peteryates1/atari800-spinalhdl/boards/rp2040-qmtech-10cl025/20260721_135031.jpg

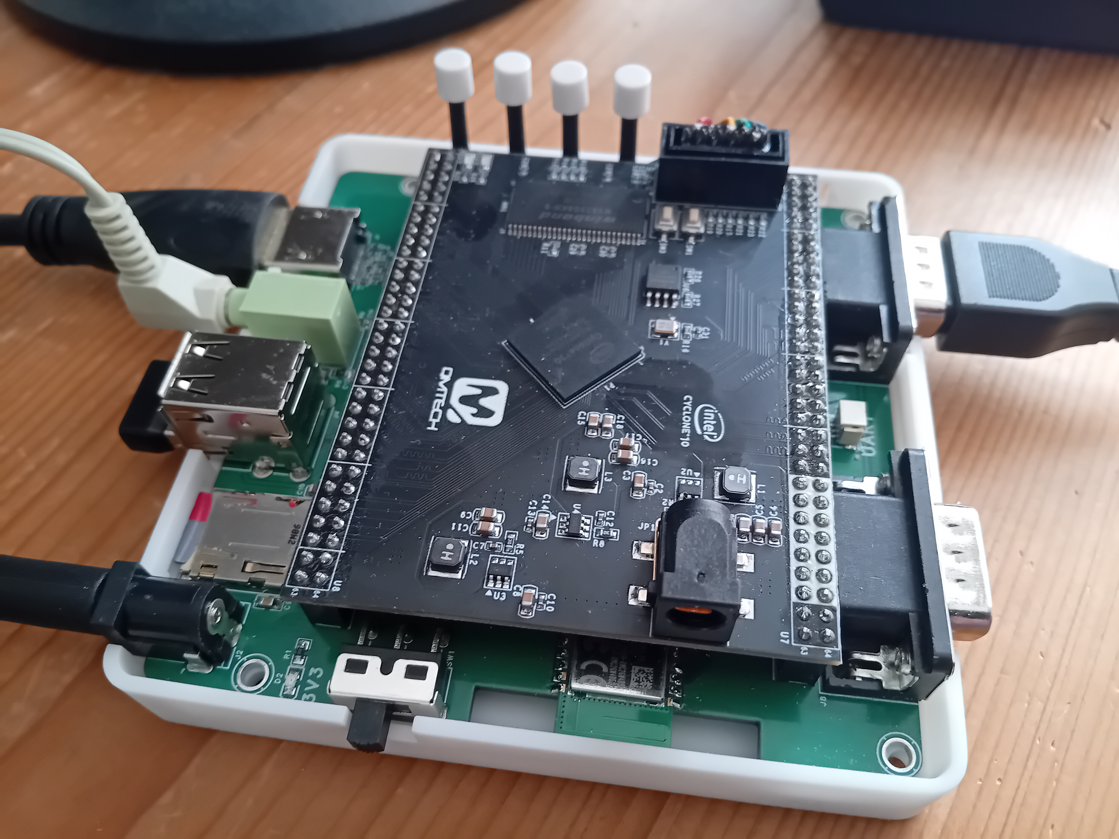
boards/rp2040-qmtech-10cl025/20260721_135031.jpg
