peteryates1/atari800-spinalhdl/boards/rp2040-qmtech-10cl025/20260721_135143.jpg

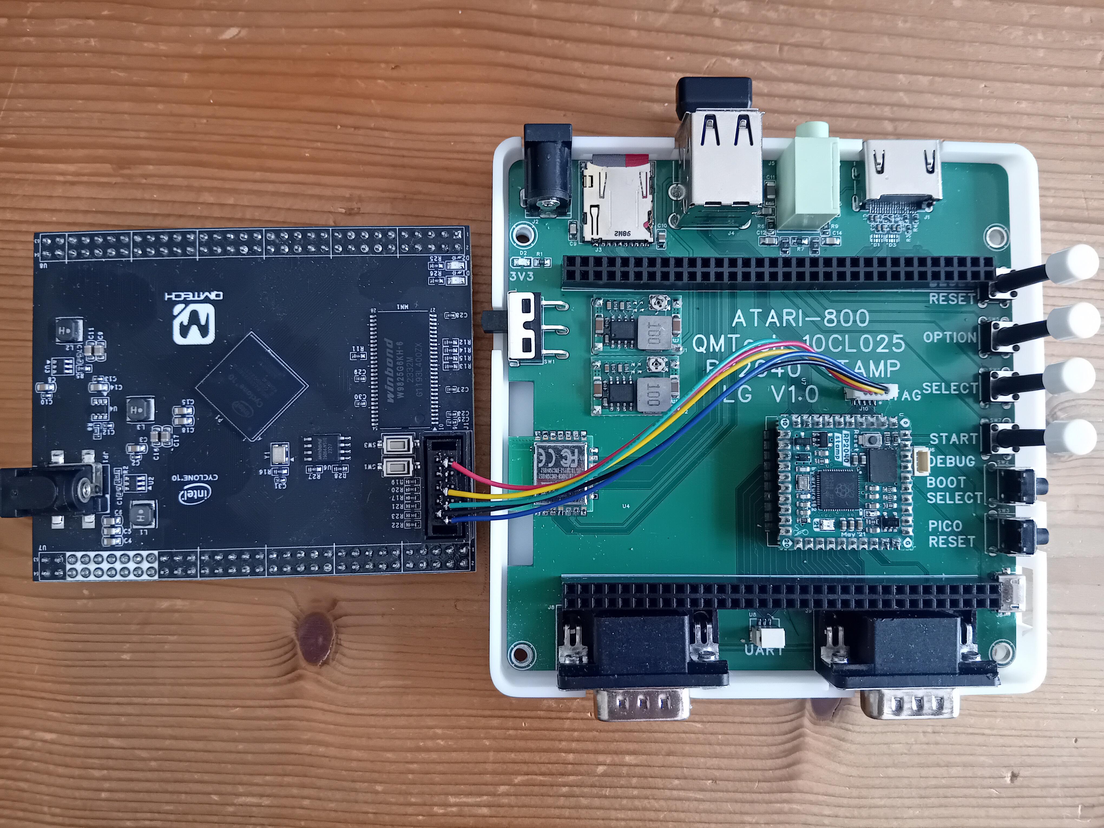
boards/rp2040-qmtech-10cl025/20260721_135143.jpg
