peteryates1/atari800-spinalhdl/boards/fpga-db-colorlight-i5/BOM_fpga-db-colorlight-i5_fpga-db-colorlight-i5_2026-08-14.csv

No. | Quantity | Comment | Value | Manufacturer Part | Designator | Footprint
1 | 16 | 100nF | 100nF | CC0402KRX7R7BB104 | C1,C2,C3,C4,C5,C6,C7,C8,C9,C10,C17,C19,C25,C26,C28,C30 | C0402
2 | 2 | 100uF | 100uF | CL31A107MQHNNNE | C11,C16 | C1206
3 | 4 | 10nF | 10nF | CL21B103KBANNNC | C12,C13,C14,C15 | C0805
4 | 7 | 10uF | 10uF | CL21A106KAYNNNE | C18,C24,C27,C29,C31,C32,C33 | C0805
5 | 4 | 22nF | 22nF | CC0402KRX7R7BB104 | C20,C21,C22,C23 | C0402
6 | 2 | AZ1045-04F |  | AZ1045-04F | D1,D2 | DFN2510-10_L2.5-W1.0-P0.50-BL
7 | 9 | LED_0805-R |  |  | D3,D4,D5,D6,D7,D8,D9,D10,D11 | LED0805-R-RD
8 | 1 | HDR-M_2.54_1x2P |  |  | H1 | HDR-TH_2P-P2.54-V-M-1
9 | 1 | HDMI-01 |  | HDMI-01 | HDMI1 | USB-SMD_HDMI-01
10 | 1 | DC-005-2.5-EP |  | DC-005-2.5-EP | J1 | DC-IN-TH_DC-005-2.5-EP
11 | 1 | BM05B-SRSS-TB(LF)(SN) |  | BM05B-SRSS-TB(LF)(SN) | J2 | CONN-SMD-5P-P1.00_BM05B-SRSS-TB-LF-SN
12 | 1 | USB2.0-AF-SS-17.6 |  | USB2.0-AF-SS-17.6 | J3 | USB-A-TH_USB2.0-AF-SS-17.6
13 | 1 | U-F-M5SS-W-1 |  | U-F-M5SS-W-1 | J4 | MICRO-USB-SMD_U-F-M5SS-W-1
14 | 1 | PJ-325C5-G |  | PJ-325C5-G | J5 | AUDIO-TH_PJ-325C5-G
15 | 2 | XDDB-1809-0816 |  | XDDB-1809-0816 | J6,J7 | DB9-TH_LD09P33E4GV00LF
16 | 1 | {ManufacturerPart!} |  | DM3AT-SF-PEJM5 | J8 | SD-SMD_DM3AT-SF-PEJM5
17 | 11 | 300Ω | 300Ω |  | R1,R10,R11,R12,R13,R14,R15,R16,R17,R18,R19 | R0402
18 | 6 | 10kΩ | 10kΩ | FRC0402F1002TS | R2,R3,R4,R21,R22,R23 | R0402
19 | 4 | 560Ω | 560Ω | 0805W8F5600T5E | R5,R6,R8,R9 | R0805
20 | 1 | 0Ω | 0Ω |  | R20 | R0402
21 | 1 | HR911130A |  | HR911130A | RJ1 | RJ45-TH_HR911130A
22 | 1 | SS12D11G5 |  | SS12D11G5 | SW1 | SW-TH_SS12D11G5
23 | 6 | TS-1088-AR02016 |  | TS-1088-AR02016 | SW2,SW3,SW4,SW5,SW6,SW7 | SW-SMD_L3.9-W3.0-P4.45
24 | 1 | DSN-MINI-360 |  |  | U1 | DSN-MINI-360
25 | 1 | RP2040_Stamp_RP2040_Stamp | RP2040_Stamp |  | U2 | RP2040_Stamp_THT
26 | 1 | IS63LV1024L-10TLI |  | IS63LV1024L-10TLI | U3 | TSOP-32_L21.0-W10.2-P1.27-LS11.8-BL
27 | 1 | SM03B-SRSS-TB(LF)(SN) |  | SM03B-SRSS-TB(LF)(SN) | U4 | CONN-SMD_SM03B-SRSS-TB-LF-SN-P
28 | 1 | colorlight-i9+ horz |  |  | U5 | CONN-SMD_200P-P0.60_AS0A426-K2SN-4H
