peteryates1/atari800-spinalhdl/boards/atari800-lg-v1.1/hw/3DShell_ATARI-800-QMTechCB-LG-V1_1/3DShell_3DShell_ATARI-800-QMTechCB-LG-V1_1_B.step

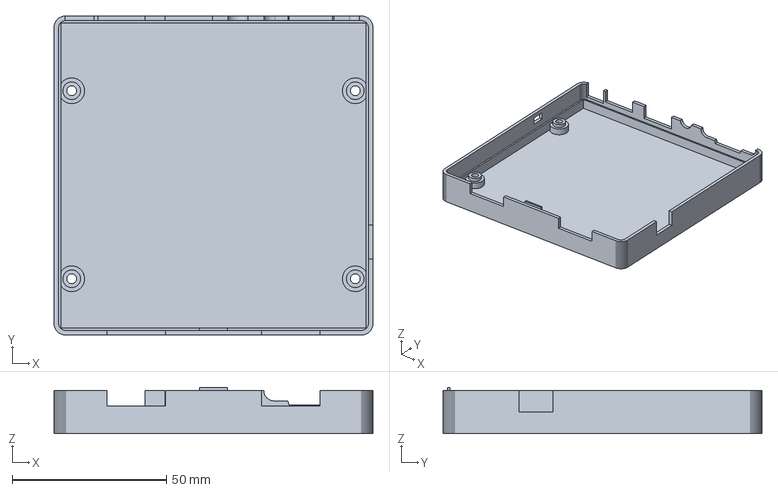
[picture p6: CAD file, 2026-05-06, last stored version]
boards/atari800-lg-v1.1/hw/3DShell_ATARI-800-QMTechCB-LG-V1_1/3DShell_3DShell_ATARI-800-QMTechCB-LG-V1_1_B.step
103.5 x 103.5 x 15.0 mm
