peteryates1/atari800-spinalhdl/boards/rp2040-qmtech-xc7a100t/SCH_ATARI-800-QMTech-XC7A100T-CB-RP2040-STAMP-HDMI_1_2026-07-22.pdf

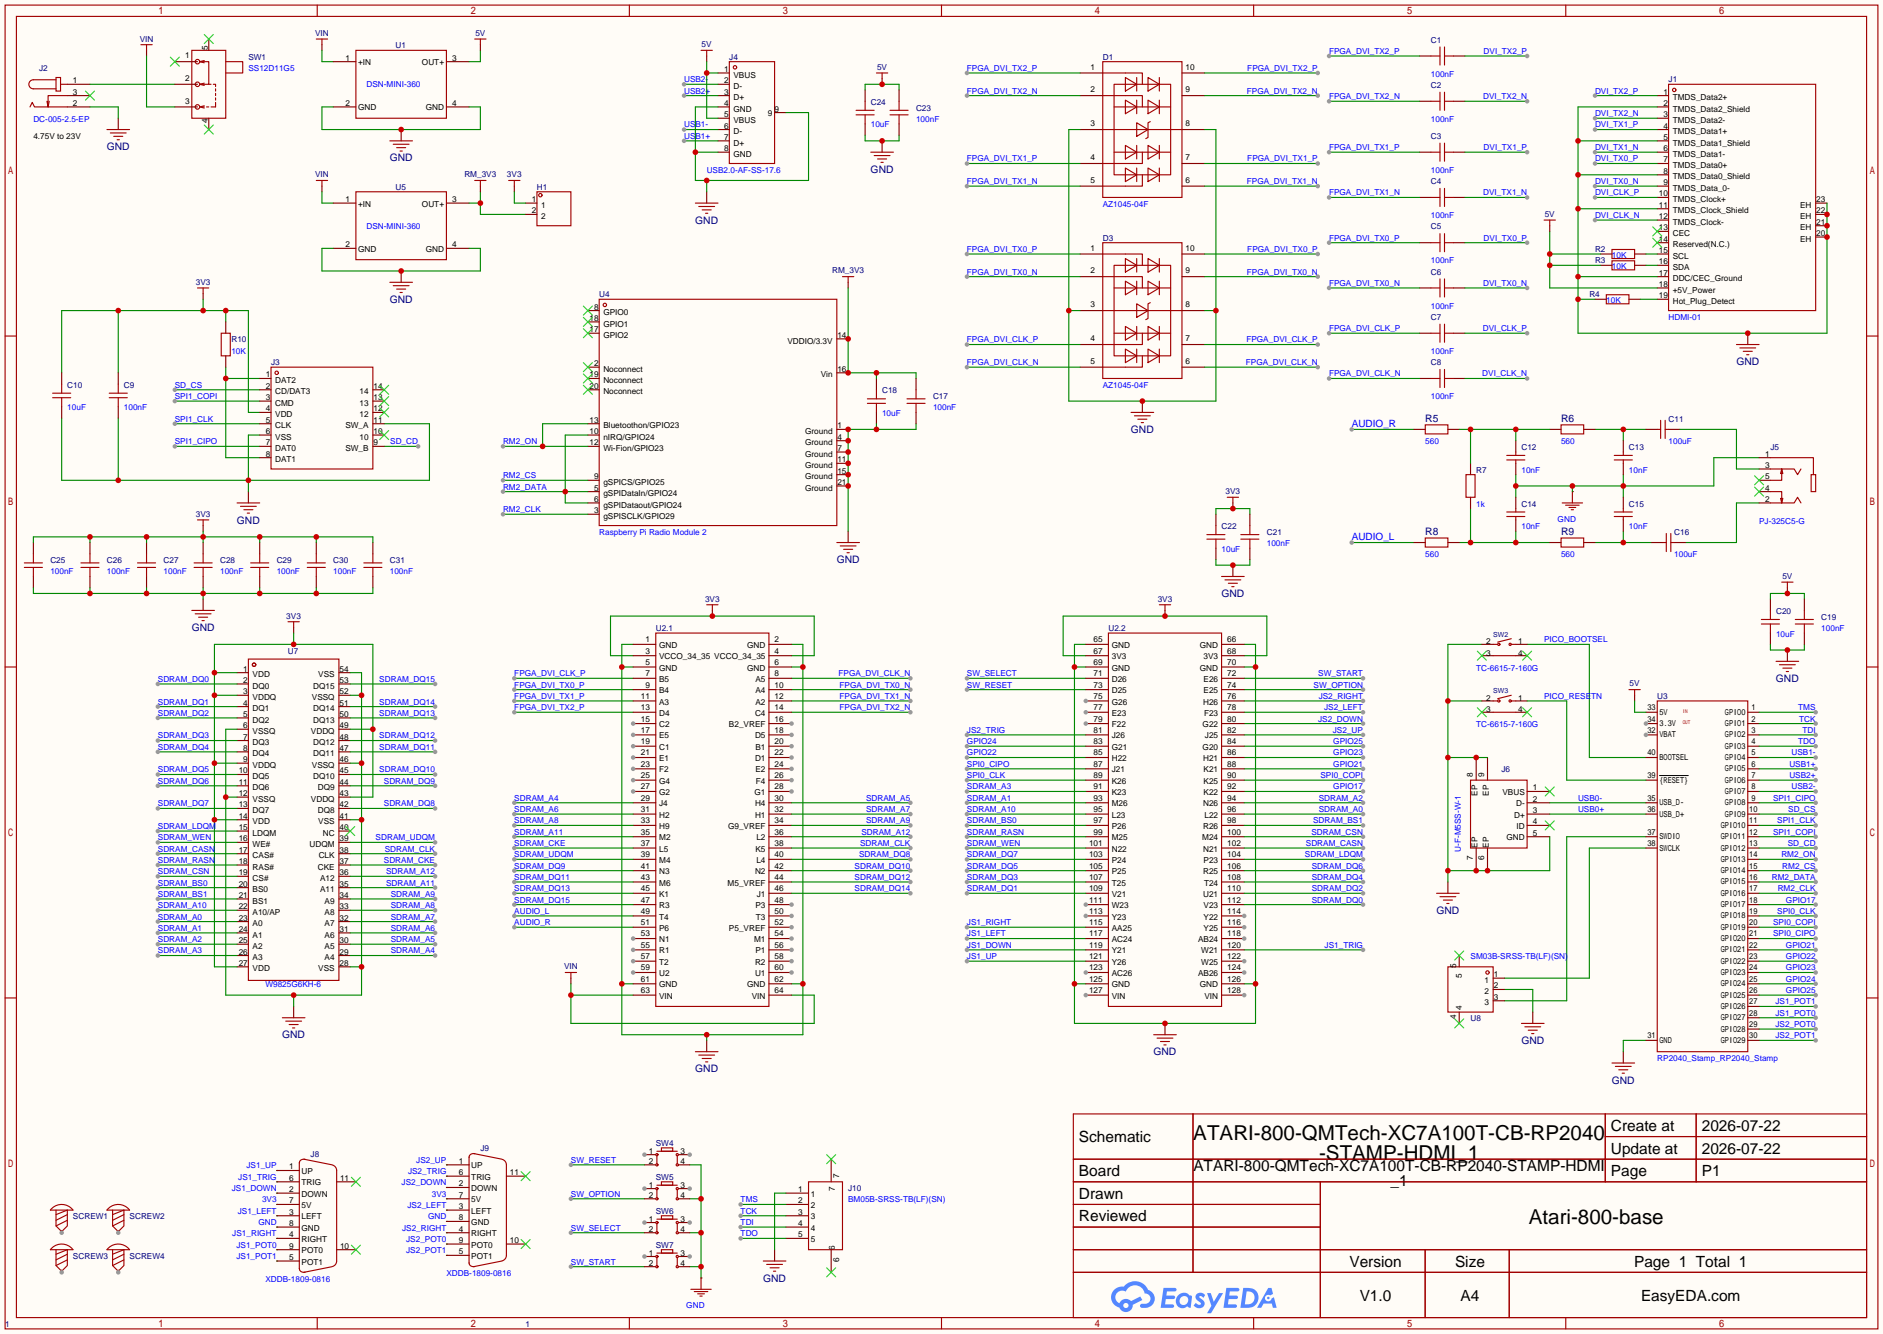
[picture p7: page 1]

Ground 1
Ground 4
Ground 21 Ground 15 Ground 11 Ground 7

Raspberry Pi Radio Module 2

GND
VIN 128 GND 126 AB26 124 W25 122 W21 120 AB24 118 Y25 116 Y22 114 V23 112 U21 110 T24 108 R25 106 P23 104 N21 102 M24 100 R26 98 L22 96 N26 94 K22 92 K25 90 K21 88 H21 86 G20 84 J25 82 G22 80 F23 78 H26 76 E25 74 E26 72 GND 70 3V3 68 GND 66

VIN 127 GND 125 AC26 123 Y26 121 Y21 119 AC24 117 AA25 115 Y23 113 W23 111 V21 109 T25 107 P25 105 P24 103 N22 101 M25 99 P26 97 L23 95 M26 93 K23 91 K26 89 J21 87 H22 85 G21 83 J26 81 F22 79 E23 77 G26 75 D25 73 D26 71 GND 69 3V3 67 GND 65

Schematic | ATARI-800-QMTech-XC7A100T-CB-RP2040 -STAMP-HDMI_1 | Create at | 2026-07-22

Update at | 2026-07-22

Board | ATARI-800-QMTech-XC7A100T-CB-RP2040-STAMP-HDMI | Page | P1

Version | Size | Page 1 Total 1
V1.0 | A4 | EasyEDA.com
