peteryates1/atari800-spinalhdl/boards/rp2040-colorlight/fpga/i9plus.xdc

# Colorlight i9+ (XC7A50T-FGG484) base-board pin map — generated from netlist
set_property -dict { PACKAGE_PIN R2 IOSTANDARD LVCMOS33 } [get_ports { GPIO17 }]
set_property -dict { PACKAGE_PIN P5 IOSTANDARD LVCMOS33 } [get_ports { JS2_RIGHT }]
set_property -dict { PACKAGE_PIN T6 IOSTANDARD LVCMOS33 } [get_ports { JS2_LEFT }]
set_property -dict { PACKAGE_PIN U7 IOSTANDARD LVCMOS33 } [get_ports { JS2_DOWN }]
set_property -dict { PACKAGE_PIN U6 IOSTANDARD LVCMOS33 } [get_ports { JS2_TRIG }]
set_property -dict { PACKAGE_PIN T3 IOSTANDARD LVCMOS33 } [get_ports { GPIO16 }]
set_property -dict { PACKAGE_PIN U5 IOSTANDARD LVCMOS33 } [get_ports { JS2_UP }]
set_property -dict { PACKAGE_PIN T4 IOSTANDARD LVCMOS33 } [get_ports { GPIO15 }]
set_property -dict { PACKAGE_PIN V5 IOSTANDARD LVCMOS33 } [get_ports { JS1_RIGHT }]
set_property -dict { PACKAGE_PIN U1 IOSTANDARD LVCMOS33 } [get_ports { JS1_LEFT }]
set_property -dict { PACKAGE_PIN U2 IOSTANDARD LVCMOS33 } [get_ports { GPIO14 }]
set_property -dict { PACKAGE_PIN H3 IOSTANDARD LVCMOS33 } [get_ports { JS1_DOWN }]
set_property -dict { PACKAGE_PIN U3 IOSTANDARD LVCMOS33 } [get_ports { GPIO13 }]
set_property -dict { PACKAGE_PIN J1 IOSTANDARD LVCMOS33 } [get_ports { JS1_TRIG }]
set_property -dict { PACKAGE_PIN V2 IOSTANDARD LVCMOS33 } [get_ports { GPIO12 }]
set_property -dict { PACKAGE_PIN K1 IOSTANDARD LVCMOS33 } [get_ports { JS1_UP }]
set_property -dict { PACKAGE_PIN V3 IOSTANDARD LVCMOS33 } [get_ports { GPIO11 }]
set_property -dict { PACKAGE_PIN L1 IOSTANDARD LVCMOS33 } [get_ports { SW_RESET }]
set_property -dict { PACKAGE_PIN W1 IOSTANDARD LVCMOS33 } [get_ports { GPIO10 }]
set_property -dict { PACKAGE_PIN M1 IOSTANDARD LVCMOS33 } [get_ports { SW_OPTION }]
set_property -dict { PACKAGE_PIN Y1 IOSTANDARD LVCMOS33 } [get_ports { GPIO9 }]
set_property -dict { PACKAGE_PIN J2 IOSTANDARD LVCMOS33 } [get_ports { SW_SELECT }]
set_property -dict { PACKAGE_PIN AA1 IOSTANDARD LVCMOS33 } [get_ports { FPGA_DVI_CLK_N }]
set_property -dict { PACKAGE_PIN K2 IOSTANDARD LVCMOS33 } [get_ports { SW_START }]
set_property -dict { PACKAGE_PIN AB1 IOSTANDARD LVCMOS33 } [get_ports { FPGA_DVI_CLK_P }]
set_property -dict { PACKAGE_PIN W2 IOSTANDARD LVCMOS33 } [get_ports { GPIO18 }]
set_property -dict { PACKAGE_PIN Y2 IOSTANDARD LVCMOS33 } [get_ports { GPIO19 }]
set_property -dict { PACKAGE_PIN AB2 IOSTANDARD LVCMOS33 } [get_ports { GPIO21 }]
set_property -dict { PACKAGE_PIN AA3 IOSTANDARD LVCMOS33 } [get_ports { FPGA_DVI_TX0_N }]
set_property -dict { PACKAGE_PIN AB3 IOSTANDARD LVCMOS33 } [get_ports { GPIO20 }]
set_property -dict { PACKAGE_PIN Y3 IOSTANDARD LVCMOS33 } [get_ports { FPGA_DVI_TX0_P }]
set_property -dict { PACKAGE_PIN R3 IOSTANDARD LVCMOS33 } [get_ports { LED3 }]
set_property -dict { PACKAGE_PIN M3 IOSTANDARD LVCMOS33 } [get_ports { LED2 }]
set_property -dict { PACKAGE_PIN V4 IOSTANDARD LVCMOS33 } [get_ports { LED1 }]
set_property -dict { PACKAGE_PIN R4 IOSTANDARD LVCMOS33 } [get_ports { LED0 }]
set_property -dict { PACKAGE_PIN T5 IOSTANDARD LVCMOS33 } [get_ports { SRAM_A0 }]
set_property -dict { PACKAGE_PIN J5 IOSTANDARD LVCMOS33 } [get_ports { SRAM_A16 }]
set_property -dict { PACKAGE_PIN Y6 IOSTANDARD LVCMOS33 } [get_ports { FPGA_DVI_TX1_N }]
set_property -dict { PACKAGE_PIN J6 IOSTANDARD LVCMOS33 } [get_ports { SRAM_A1 }]
set_property -dict { PACKAGE_PIN W5 IOSTANDARD LVCMOS33 } [get_ports { SRAM_A15 }]
set_property -dict { PACKAGE_PIN AA6 IOSTANDARD LVCMOS33 } [get_ports { FPGA_DVI_TX1_P }]
set_property -dict { PACKAGE_PIN L5 IOSTANDARD LVCMOS33 } [get_ports { SRAM_A2 }]
set_property -dict { PACKAGE_PIN L6 IOSTANDARD LVCMOS33 } [get_ports { SRAM_A14 }]
set_property -dict { PACKAGE_PIN W6 IOSTANDARD LVCMOS33 } [get_ports { SRAM_A3 }]
set_property -dict { PACKAGE_PIN AA8 IOSTANDARD LVCMOS33 } [get_ports { FPGA_DVI_TX2_N }]
set_property -dict { PACKAGE_PIN V7 IOSTANDARD LVCMOS33 } [get_ports { SRAM_A13 }]
set_property -dict { PACKAGE_PIN AB8 IOSTANDARD LVCMOS33 } [get_ports { FPGA_DVI_TX2_P }]
set_property -dict { PACKAGE_PIN N13 IOSTANDARD LVCMOS33 } [get_ports { SRAM_CE_N }]
set_property -dict { PACKAGE_PIN N14 IOSTANDARD LVCMOS33 } [get_ports { SRAM_OE_N }]
set_property -dict { PACKAGE_PIN P15 IOSTANDARD LVCMOS33 } [get_ports { SRAM_D0 }]
set_property -dict { PACKAGE_PIN P16 IOSTANDARD LVCMOS33 } [get_ports { SRAM_D7 }]
set_property -dict { PACKAGE_PIN R16 IOSTANDARD LVCMOS33 } [get_ports { SRAM_D1 }]
set_property -dict { PACKAGE_PIN N17 IOSTANDARD LVCMOS33 } [get_ports { SRAM_D6 }]
set_property -dict { PACKAGE_PIN T18 IOSTANDARD LVCMOS33 } [get_ports { SRAM_D5 }]
set_property -dict { PACKAGE_PIN R17 IOSTANDARD LVCMOS33 } [get_ports { SRAM_D2 }]
set_property -dict { PACKAGE_PIN U18 IOSTANDARD LVCMOS33 } [get_ports { SRAM_D4 }]
set_property -dict { PACKAGE_PIN R18 IOSTANDARD LVCMOS33 } [get_ports { SRAM_D3 }]
set_property -dict { PACKAGE_PIN N18 IOSTANDARD LVCMOS33 } [get_ports { SRAM_A12 }]
set_property -dict { PACKAGE_PIN R19 IOSTANDARD LVCMOS33 } [get_ports { SRAM_WE_N }]
set_property -dict { PACKAGE_PIN N19 IOSTANDARD LVCMOS33 } [get_ports { SRAM_A11 }]
set_property -dict { PACKAGE_PIN N15 IOSTANDARD LVCMOS33 } [get_ports { SRAM_A4 }]
set_property -dict { PACKAGE_PIN M16 IOSTANDARD LVCMOS33 } [get_ports { SRAM_A10 }]
set_property -dict { PACKAGE_PIN M15 IOSTANDARD LVCMOS33 } [get_ports { SRAM_A5 }]
set_property -dict { PACKAGE_PIN L15 IOSTANDARD LVCMOS33 } [get_ports { SRAM_A9 }]
set_property -dict { PACKAGE_PIN L16 IOSTANDARD LVCMOS33 } [get_ports { SRAM_A6 }]
set_property -dict { PACKAGE_PIN AB21 IOSTANDARD LVCMOS33 } [get_ports { AUDIO_R }]
set_property -dict { PACKAGE_PIN K14 IOSTANDARD LVCMOS33 } [get_ports { SRAM_A8 }]
set_property -dict { PACKAGE_PIN Y21 IOSTANDARD LVCMOS33 } [get_ports { AUDIO_L }]
set_property -dict { PACKAGE_PIN N22 IOSTANDARD LVCMOS33 } [get_ports { SRAM_A7 }]
