peteryates1/atari800-spinalhdl/firmware/supervisor/tusb_config.h

/*
 * The MIT License (MIT)
 *
 * Copyright (c) 2019 Ha Thach (tinyusb.org)
 *
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
 */

#ifndef TUSB_CONFIG_H_
#define TUSB_CONFIG_H_

#ifdef __cplusplus
 extern "C" {
#endif

//--------------------------------------------------------------------+
// Board Specific Configuration
//--------------------------------------------------------------------+

// RHPort number used for device can be defined by board.mk, default to port 0
#ifndef BOARD_TUD_RHPORT
#define BOARD_TUD_RHPORT      0
#endif

// RHPort max operational speed can defined by board.mk
#ifndef BOARD_TUD_MAX_SPEED
#define BOARD_TUD_MAX_SPEED   OPT_MODE_DEFAULT_SPEED
#endif

// RHPort number used for host can be defined by board.mk, default to port 1
#ifndef BOARD_TUH_RHPORT
#define BOARD_TUH_RHPORT      1
#endif

// RHPort max operational speed can defined by board.mk
#ifndef BOARD_TUH_MAX_SPEED
#define BOARD_TUH_MAX_SPEED   OPT_MODE_DEFAULT_SPEED
#endif

//--------------------------------------------------------------------
// COMMON CONFIGURATION
//--------------------------------------------------------------------

// defined by compiler flags for flexibility
#ifndef CFG_TUSB_MCU
#error CFG_TUSB_MCU must be defined
#endif

#ifndef CFG_TUSB_OS
#define CFG_TUSB_OS           OPT_OS_NONE
#endif

#ifndef CFG_TUSB_DEBUG
#define CFG_TUSB_DEBUG        0
#endif

// Enable Device stack, Default is max speed that hardware controller could support with on-chip PHY
#define CFG_TUD_ENABLED       1
#define CFG_TUD_MAX_SPEED     BOARD_TUD_MAX_SPEED

// Enable Host stack, Default is max speed that hardware controller could support with on-chip PHY
#define CFG_TUH_ENABLED       1
#define CFG_TUH_MAX_SPEED     BOARD_TUH_MAX_SPEED

#if CFG_TUSB_MCU == OPT_MCU_RP2040
// Use pico-pio-usb as host controller for raspberry rp2040
#define CFG_TUH_RPI_PIO_USB   1
#endif

/* USB DMA on some MCUs can only access a specific SRAM region with restriction on alignment.
 * Tinyusb use follows macros to declare transferring memory so that they can be put
 * into those specific section.
 * e.g
 * - CFG_TUSB_MEM SECTION : __attribute__ (( section(".usb_ram") ))
 * - CFG_TUSB_MEM_ALIGN   : __attribute__ ((aligned(4)))
 */
#ifndef CFG_TUD_MEM_SECTION
#define CFG_TUD_MEM_SECTION
#endif

#ifndef CFG_TUD_MEM_ALIGN
#define CFG_TUD_MEM_ALIGN        __attribute__ ((aligned(4)))
#endif

//--------------------------------------------------------------------
// DEVICE CONFIGURATION
//--------------------------------------------------------------------

#ifndef CFG_TUD_ENDPOINT0_SIZE
#define CFG_TUD_ENDPOINT0_SIZE    64
#endif

//------------- CLASS -------------//
#define CFG_TUD_CDC              1

// CDC FIFO size of TX and RX
#define CFG_TUD_CDC_RX_BUFSIZE   (TUD_OPT_HIGH_SPEED ? 512 : 64)
#define CFG_TUD_CDC_TX_BUFSIZE   (TUD_OPT_HIGH_SPEED ? 512 : 64)

// CDC Endpoint transfer buffer size, more is faster
#define CFG_TUD_CDC_EP_BUFSIZE   (TUD_OPT_HIGH_SPEED ? 512 : 64)

// Vendor class: used only for the USB-Blaster (FTDI 09fb:6001) identity that
// the device re-enumerates into for FPGA JTAG programming (see blaster.c /
// g_blaster_mode). Buffers per the pico-usb-blaster reference: a large RX FIFO
// keeps NAKs down when jtagd streams; TX is one FT245 packet.
#define CFG_TUD_VENDOR            1
#define CFG_TUD_VENDOR_EPSIZE     64
#define CFG_TUD_VENDOR_RX_BUFSIZE 1024
#define CFG_TUD_VENDOR_TX_BUFSIZE 64

// Mass Storage: exposes the SD card as a USB drive so files/configs can be
// dropped and edited without pulling the card (see msc_disk.c). One 512-byte
// block per bulk transfer.
#define CFG_TUD_MSC               1
#define CFG_TUD_MSC_EP_BUFSIZE    512

//--------------------------------------------------------------------
// HOST CONFIGURATION
//--------------------------------------------------------------------

// Size of buffer to hold descriptors and other data used for enumeration
#define CFG_TUH_ENUMERATION_BUFSIZE 256

#ifndef CFG_TUH_MEM_SECTION
#define CFG_TUH_MEM_SECTION
#endif

#ifndef CFG_TUH_MEM_ALIGN
#define CFG_TUH_MEM_ALIGN           __attribute__ ((aligned(4)))
#endif

#define CFG_TUH_HUB                 1
// max device support (excluding hub device)
#define CFG_TUH_DEVICE_MAX          (CFG_TUH_HUB ? 4 : 1) // hub typically has 4 ports

#define CFG_TUH_HID                 (3*CFG_TUH_DEVICE_MAX)
// Ask boot-capable keyboards for the simple 8-byte boot protocol at mount
#define CFG_TUH_HID_DEFAULT_PROTOCOL HID_PROTOCOL_BOOT
#define CFG_TUH_HID_EPIN_BUFSIZE    64
#define CFG_TUH_HID_EPOUT_BUFSIZE   64

#ifdef __cplusplus
 }
#endif

#endif
