peteryates1/atari800-spinalhdl/boards/i5-7v0/oddrx2f_720/pll_hdmi_ecp5.sv

// diamond 3.7 accepts this PLL
// diamond 3.8-3.9 is untested
// diamond 3.10 or higher is likely to abort with error about unable to use feedback signal
// cause of this could be from wrong CPHASE/FPHASE parameters
module pll_hdmi_ecp5
(
    input clkin, // 25 MHz, 0 deg
    output clkout0, // 370 MHz, 0 deg (serial)
    output clkout1, // 74 MHz, 0 deg (pixel)
    output clkout2, // 37 MHz, 0 deg (Atari sys) - VCO=740/20, phase-locked to pixel (1:2)
    output locked
);
(* FREQUENCY_PIN_CLKI="25" *)
(* FREQUENCY_PIN_CLKOP="370" *)
(* FREQUENCY_PIN_CLKOS="74" *)
(* FREQUENCY_PIN_CLKOS2="37" *)
(* ICP_CURRENT="12" *) (* LPF_RESISTOR="8" *) (* MFG_ENABLE_FILTEROPAMP="1" *) (* MFG_GMCREF_SEL="2" *)
EHXPLLL #(
        .PLLRST_ENA("DISABLED"),
        .INTFB_WAKE("DISABLED"),
        .STDBY_ENABLE("DISABLED"),
        .DPHASE_SOURCE("DISABLED"),
        .OUTDIVIDER_MUXA("DIVA"),
        .OUTDIVIDER_MUXB("DIVB"),
        .OUTDIVIDER_MUXC("DIVC"),
        .OUTDIVIDER_MUXD("DIVD"),
        .CLKI_DIV(5),
        .CLKOP_ENABLE("ENABLED"),
        .CLKOP_DIV(2),
        .CLKOP_CPHASE(1),
        .CLKOP_FPHASE(0),
        .CLKOS_ENABLE("ENABLED"),
        .CLKOS_DIV(10),
        .CLKOS_CPHASE(1),
        .CLKOS_FPHASE(0),
        .CLKOS2_ENABLE("ENABLED"),
        .CLKOS2_DIV(20),
        .CLKOS2_CPHASE(1),
        .CLKOS2_FPHASE(0),
        .FEEDBK_PATH("CLKOP"),
        .CLKFB_DIV(74)
    ) pll_i (
        .RST(1'b0),
        .STDBY(1'b0),
        .CLKI(clkin),
        .CLKOP(clkout0),
        .CLKOS(clkout1),
        .CLKOS2(clkout2),
        .CLKFB(clkout0),
        .CLKINTFB(),
        .PHASESEL0(1'b0),
        .PHASESEL1(1'b0),
        .PHASEDIR(1'b1),
        .PHASESTEP(1'b1),
        .PHASELOADREG(1'b1),
        .PLLWAKESYNC(1'b0),
        .ENCLKOP(1'b0),
        .LOCK(locked)
	);
endmodule
