peteryates1/atari800-spinalhdl/firmware/supervisor/ft245_eeprom.h

// Reproduction of the EEPROM from the original Altera "USB Blaster".
// Derived from the code at http://sa89a.net/mp.cgi/ele/ub.htm
// Returned to the host via the FTDI READ_EEPROM (0x90) vendor control request
// so Quartus / jtagd accept the device as a genuine USB-Blaster.
#pragma once

#include <stdint.h>

#define FT245_EEPROM_LENGTH (sizeof(FT245_EEPROM)/sizeof(FT245_EEPROM[0]))

static uint8_t FT245_EEPROM[] = {
    0x00, 0x00, 0xFB, 0x09, 0x01, 0x60, 0x00, 0x04, 	// 0x00 - 0x07
    0x80, 0x28, 0x1C, 0x00, 0x10, 0x01, 0x94, 0x0E, 	// 0x08 - 0x0F
    0xA2, 0x18, 0xBA, 0x12, 0x0E, 0x03, 0x41, 0x00, 	// 0x10 - 0x17
    0x6C, 0x00, 0x74, 0x00, 0x65, 0x00, 0x72, 0x00, 	// 0x18 - 0x1F
    0x61, 0x00, 0x18, 0x03, 0x55, 0x00, 0x53, 0x00, 	// 0x20 - 0x27
    0x42, 0x00, 0x2D, 0x00, 0x42, 0x00, 0x6C, 0x00, 	// 0x28 - 0x2F
    0x61, 0x00, 0x73, 0x00, 0x74, 0x00, 0x65, 0x00, 	// 0x30 - 0x37
    0x72, 0x00, 0x12, 0x03, 0x30, 0x00, 0x30, 0x00, 	// 0x38 - 0x3F
    0x30, 0x00, 0x30, 0x00, 0x30, 0x00, 0x30, 0x00, 	// 0x40 - 0x47
    0x30, 0x00, 0x30, 0x00, 0x01, 0x02, 0x03, 0x01, 	// 0x48 - 0x4F
    0x00, 0x00, 0x00, 0x00, 0x00, 0x00, 0x00, 0x00, 	// 0x50 - 0x57
    0x00, 0x00, 0x00, 0x00, 0x00, 0x00, 0x00, 0x00, 	// 0x58 - 0x5F
    0x00, 0x00, 0x00, 0x00, 0x00, 0x00, 0x00, 0x00, 	// 0x60 - 0x67
    0x00, 0x00, 0x00, 0x00, 0x00, 0x00, 0x00, 0x00, 	// 0x68 - 0x6F
    0x00, 0x00, 0x00, 0x00, 0x00, 0x00, 0x00, 0x00, 	// 0x70 - 0x77
    0x00, 0x00, 0x00, 0x00, 0x00, 0x00, 0x85, 0xD0, 	// 0x78 - 0x7F
};
