peteryates1/atari800-spinalhdl/boards/rp2040-qmtech-10cl025/hdmi_ref_480/rtl/hdmi_color.v

/***************************************************
*	Module Name		:	hdmi_color		   
*	Engineer			:	小梅哥
*	Target Device	:	10CL025YU256C8
*	Tool versions	:	Quartus Prime 18.1
*	Create Date		:	2021-12-20
*	Revision			:	v1.0
*	Description		:  HDMI彩条实验顶层模块设计
**************************************************/

module hdmi_color(
	input clk,
	input rst_n,
	
	//hdmi output
	output tmds_clk_p,
	output tmds_clk_n,
	output [2:0] tmds_data_p, //rgb
	output [2:0] tmds_data_n //rgb
);

	wire clk_vga;//25m (640x480 test — was 74.25m)
	wire clk_vgax5;//125m (5x — was 371.25m)

	// Reuse the proven atari_pll (25 MHz c1 / 125 MHz c2) instead of pll_hdmi.
	atari_pll pll_hdmi_inst(
		.areset(1'b0),
		.inclk0(clk),
		.c0(),
		.c1(clk_vga),
		.c2(clk_vgax5),
		.c3(),
		.locked()
	);

	wire [11:0] hcount;
	wire [11:0] vcount;
	wire [23:0] disp_data;
	color_bar u_color_bar(
		.hcount(hcount),
		.vcount(vcount),
		.disp_data(disp_data)
	);
 
	wire video_hs;
	wire video_vs;
	wire video_de;
	wire [7:0] video_r;
	wire [7:0] video_g;
	wire [7:0] video_b;
 
	disp_driver disp_driver(
		.ClkDisp(clk_vga),
		.Rst_n(rst_n),
		.Data(disp_data),
		.DataReq(),
		.H_Addr(hcount),
		.V_Addr(vcount),
		.Disp_HS(video_hs),
		.Disp_VS(video_vs),
		.Disp_Red(video_r),
		.Disp_Green(video_g),
		.Disp_Blue(video_b),
		.Disp_DE(video_de),
		.Disp_PCLK()
	);
	
	dvi_encoder u_dvi_encoder(
		.pixelclk(clk_vga),// system clock
		.pixelclk5x(clk_vgax5),// system clock x5
		.rst_n(rst_n),// reset
		.blue_din(video_b),// Blue data in
		.green_din(video_g),// Green data in
		.red_din(video_r),// Red data in
		.hsync(video_hs),// hsync data
		.vsync(video_vs),// vsync data
		.de(video_de),// data enable
		.tmds_clk_p(tmds_clk_p),
		.tmds_clk_n(tmds_clk_n),
		.tmds_data_p(tmds_data_p),//rgb
		.tmds_data_n(tmds_data_n) //rgb
	);
 
endmodule
