peteryates1/atari800-spinalhdl/(commit log)

2026-03-12 Update for pluggable I/O: rename BmbAtariCtrl→AtariCtrl, unified build
    - Rename BmbAtariCtrl → AtariCtrl (no BMB signals)
    - Move JopCoreForAtari from jop-bridge to atari/
    - Delete jop-bridge/GenerateJopForAtari (replaced by Generate.scala)
    - Update Atari800JopTop for HasBusIo device renames
    - Update build.sbt for unified build structure
    - Update jop-spinalhdl submodule to pluggable I/O commit
2026-03-15 Fix GTIA highres color bug, add simulation frame capture
    Fix off-by-one bit index in GTIA highres luminance replacement:
    colpf1DelayedReg(3 downto 1) -> colpf1DelayedReg(2 downto 0).
    VHDL signal was (7 downto 1) based, SpinalHDL is (6 downto 0) based,
    so VHDL indices (3 downto 1) = SpinalHDL (2 downto 0). This made
    mode 2 foreground color identical to background, rendering text
    invisible. Memo pad now displays correctly with $9A foreground on
    $94 background.
    Add raw Atari video frame capture to testbench with PAL palette
    lookup, producing PPM images. Add simPublic() to various internal
    signals for debug access. Add JOP integration sim files.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
2026-03-15 Add cartridge ROM loading, BASIC support, full PAL palette, update README
    Add cartridge_rom parameter to load 8K ROM files (e.g. Star Raiders)
    at elaboration time into the $A000-$BFFF slot. When no file specified,
    falls back to built-in Atari BASIC ROM. Enable BASIC/cartridge in
    Atari 800 mode by wiring CART_RD5 and extending AddressDecoder to
    serve $A000-$BFFF from internal ROM.
    Replace partial PAL palette with full 256-entry lookup table extracted
    from GtiaPalette.scala. Frame captures now use cartridge-based filenames.
    Update README with current project status, simulation instructions,
    architecture overview, and bug fix documentation.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
2026-03-16 Add paddles 4-7, physical cart slot, ECP5 build flow, multi-target JOP config
    Extend AtariCtrl to all 8 paddles (4 joystick ports × 2 paddles each)
    with packed register layout fitting JOP's 4-bit I/O address limit.
    Add physical cartridge slot registers (0xA/0xB) for JOP to read cart
    ROMs and back up to SD card.
    Add configSmall/configLarge JOP cache presets for different FPGA targets.
    configSmall uses default cache sizes (16-entry caches, 16 method blocks)
    for smaller FPGAs like Colorlight i5 (ECP5 LFE5U-25F).
    Remove built-in BASIC ROM from hardware builds — JOP loads all cartridge
    ROMs from SD card at runtime. Cartridge ROM only instantiated when a
    file path is provided (simulation).
    F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
2026-03-16 ROM BRAM inference: readAsync→readSync, exclude BASIC from hardware builds
    - Replace readAsync+RegNext with readSync in all ROM components (Os8, Os16,
    Os16Loop, Os2, Os5200, Basic, InternalRomRam cartridge slot) so synthesisers
    infer block RAM instead of distributed RAM.
    - ECP5 result: LUT4 28,807 → 17,221 (71.7% of LFE5U-25F 24K limit; fits).
    DP16KD BRAM: 19/56. Only 2 small distributed-RAM instances remain
    (128B freezer, 192B ANTIC regfile).
    - Add basic_in_sdram parameter to Atari800CoreSimpleSdram (default false).
    When true (hardware builds): Basic ROM not instantiated in FPGA fabric;
    AddressDecoder routes A000-BFFF to SDRAM where JOP loads BASIC at runtime.
    Thread bas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
2026-03-16 Add i9 module ECP5 build (LFE5U-45F), switch to Quartus 25.1
    - i9/: ECP5 build for Colorlight i9 module (LFE5U-45F-6BG381C, 44K LUTs)
    Same synth_ecp5 flow as ecp5/; 17,221 LUT4 = 39% on 45F, 18% BRAM.
    Minimal LPF with 25MHz clock; full pin assignments TBD for board bring-up.
    Note: i9 has 32-bit wide SDRAM (M12L64322A); SdramStatemachine is 16-bit.
    - Makefile: default QUARTUS path updated to 25.1
    - README: i9 utilisation table, build instructions for all targets, Quartus 25.1
2026-03-16 Reorganise board build directories under boards/
    ecp5/ -> boards/i5-7v0/ (Colorlight i5, LFE5U-25F)
    i9/ -> boards/i9-7v2/ (Colorlight i9 module, LFE5U-45F)
    quartus/ -> boards/AC608/ (custom Cyclone 10 LP board)
    vivado/ -> boards/i9plus-6v1/ (Colorlight i9+, XC7A50T)
    Update all relative paths in Makefiles and synth_check.tcl.
    Update root Makefile QUARTUS_DIR, .gitignore, README build instructions.
2026-03-16 Add EP4CGX150 bring-up board; fix BRAM inference and cartridge routing
    boards/ep4cgx150/: bare-metal Atari 800 top for QMTECH EP4CGX150 +
    DB_FPGA daughter board. Boots to memo pad and Star Raiders (confirmed
    on hardware). ALTPLL 50→56.67 MHz (×17/÷15), scandoubled ~31 kHz VGA
    via 5-6-5 resistor DAC. 3,754 LEs / 313 Kbit BRAM / 1 PLL (2% of device).
    GenericRamInfer: readAsync → readSync for M9K BRAM inference on
    Cyclone IV GX. readAsync was synthesising as 52K ALUTs + 65K registers
    instead of block RAM. inRange2 updated to RegNext to match 1-cycle
    readSync latency. Write-through forwarding removed (Atari bus: reads
    and writes are mutually exclusive).
    InternalRomRam (internalRom==3): a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
    [atari_pll.sv]
2026-03-16 README: update status to hardware verified, add EP4CGX150 board
    - Status section: "not yet tested on hardware" → hardware verified on
    EP4CGX150 + DB_FPGA (memo pad and Star Raiders confirmed running)
    - Project structure: add Atari800Ep4cgx150Top.scala and ep4cgx150/ board
    - Build instructions: add EP4CGX150 make generate/build/program section
    - Resource utilisation: add EP4CGX150 table (3,754 LEs / 313 Kbit / 1 PLL)
2026-03-18 Add JOP integration: EP4CGX150 board project, simulation, ECP5 P&R fixes
    - JopCoreForAtari: fix jopAsmBase to use submodule path (not standalone)
    - Atari800Ep4cgx150JopTop, AtariBoardConfig: EP4CGX150 + JOP board top
    - boards/ep4cgx150: Quartus project files for JOP build (qsf, sdc, PLL, top)
    - Atari800JopSim/Tb: simulation testbench for JOP integration
    - SdramArbiter: updates for JOP SDRAM sharing
    - boards/i5-7v0/Makefile: fix device flag (25k), add freq/lpf-allow-unconstrained
    - boards/i9-7v2/Makefile: fix device flag (45k), add freq/lpf-allow-unconstrained
    - java/apps/AtariApp: JOP Java app (AtariCtrl I/O interface)
    - AtariApp.jop: compiled JOP application binary
    - ch376-to-pmod: CH376T t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
2026-03-18 Replace embedded ROM Scala sources with FileRom binary loader
    Remove Os8, Os2, Os16, Os16Loop, Basic, Os5200 (3,600+ lines of
    copyrighted hex data). Add FileRom.scala which loads binary .rom
    files from roms/ at elaboration time. Update InternalRomRam to use
    FileRom for all ROM variants.
    Also: fix cart_phi2 spurious clock domain (Atari800JopTop), revert
    Cpu65xx pipeline stages to disabled, add ECP5 fit_check wrappers,
    remove stale AtariApp.jop, update README.
    Hardware verified: EP4CGX150 + DB_FPGA boots Star Raiders with
    file-based ROMs.
2026-03-20 EP4CGX150 JOP BRAM-only build: Atari + JOP supervisor without SDRAM
    Atari core uses 48K BRAM (Star Raiders + OS ROM), JOP uses 256K BRAM
    for Java heap/stack with serial boot via UART at 500 kbaud. Reuses
    proven atari_pll.sv (56.67 MHz) — VGA text clock derived from 50 MHz
    input toggle. Adds joystick debounce, CH376T SPI, keyboard injection
    via AtariCtrl. QSF references generated SV in place (no copy step).
2026-03-20 Add SDRAM CKE pin and sdramReady gate to BMB-SDRAM bridge
    SdramCtrlPins was missing CKE — required for SDRAM to accept commands.
    BmbToSdramReq now gates BMB acceptance on sdramReady (from
    SdramStatemachine.reset_client_n) to prevent JOP from issuing commands
    before SDRAM initialization completes.
2026-03-20 EP4CGX150 bare-metal: switch to BRAM-only (48K, no SDRAM)
    Remove SDRAM controller and pins from bare-metal Atari build. 48K BRAM
    covers full Atari memory. SDRAM reserved for JOP supervisor. Removes
    SDRAM timing constraints from SDC and SDRAM ports from wrapper.
2026-03-20 Simulation: 48K BRAM-only mode, fix SharedEnable index bounds
    Match simulation to hardware: 48K internal RAM, RAM_SELECT=011.
    Fix SharedEnable throttle shift register index calculation to avoid
    out-of-bounds access when cycleLength power-of-2 division yields
    negative index.
2026-03-20 Update PLL files: EP4CGX150 JOP PLL matches working atari_pll.sv, ECP5 cleanup
    atari_pll_jop.sv rewritten to match working atari_pll.sv parameterization
    (bandwidth_type, lpm_hint, lpm_type, width_clock, clkena, pllena ports).
    ECP5 board files simplified for BRAM-only fit checks.
2026-03-20 Update AtariApp Java test and CH376T-to-PMOD submodule
    AtariCtrl register updates for keyboard injection and console keys.
    CH376T-to-PMOD wiring documentation updated.
2026-03-20 Update jop-spinalhdl: Custom device type, Atari config, AtariSupervisor
2026-03-25 Dual-PLL build, joystick/CH376S pin fixes, serial keyboard relay, tools
    Add dual-PLL top-level (80 MHz JOP + 56.67 MHz Atari) with CDC for
    keyboard state, joystick, and console keys. Fix joystick bit order to
    match JoystickPort.packed (FRLDU) in both single and dual-PLL tops.
    Fix CH376S RSTI polarity (active HIGH, not LOW) and correct J10/J11
    PMOD pin assignments — joystick on J10, CH376S SPI on J11 with no
    conflicts. Reduce debounce stable count from 20 to 16 bits (~1.2ms).
    Add Makefile targets for dual-PLL build/program/download at 2 Mbaud.
    Add AtariCtrl key state output pins for CDC to Atari domain.
    Tools: serial keyboard/joystick relay (atari_keyboard.py), CH376S SPI
    and UART test s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
2026-03-25 Move Atari-specific code out of jop-spinalhdl, drive build from atari side
    - Move AtariSupervisor Java app from jop-spinalhdl to java/apps/AtariSupervisor/
    - Add GenerateConstJava.scala: drives jop ConstGenerator from atari JopCoreConfig
    - Update Makefile: const-java via atari sbt, jop-app from local app dir
    - Remove old AtariApp (superseded by AtariSupervisor)
    - Update jop-spinalhdl: remove atariEp4cgx150 preset and AtariSupervisor
    - Update README with new project structure and build chain docs
    jop-spinalhdl is now a pure reusable library with no project-specific code.
2026-03-25 Dual-PLL: add JOP SDRAM, fix AlteraLpm MIF paths
    Add 32 MB SDRAM support for JOP in the dual-PLL EP4CGX150 build.
    JOP uses BmbSdramCtrl32 (Altera IP) at 80 MHz; Atari remains
    BRAM-only. SDRAM pin assignments, wrapper ports, and Altera IP
    source files added to QSF. MIF paths now passed as VHDL generics
    via updated jop-spinalhdl AlteraLpm, eliminating need for symlinks.
    Hardware verified: 13,697 LEs (9%), 660K memory bits (10%), 2 PLLs.
2026-03-25 Single-PLL: JOP and Atari both at 56.67 MHz, no CDC needed
    Replace dual-PLL (80 MHz JOP + 56.67 MHz Atari) with single PLL.
    Eliminates all BufferCC clock domain crossing between JOP and Atari,
    simplifies top-level significantly. SDRAM runs at 56.67 MHz with
    -3ns phase shift. UART baud rate reduced to 500 kbaud (2 Mbaud has
    5.5% error at 56.67 MHz). VGA text (25 MHz) still CDC'd as it runs
    from a separate PLL output. Hardware verified on EP4CGX150.
    [atari_pll.sv]
2026-03-26 VGA text overlay: per-pixel compositor, software-configurable position
    Replace the 25 MHz VGA text clock domain with a sys-clock overlay that
    reuses scandoubler timing signals (doubledEnable, hsync, vsync).
    Eliminates CDC entirely — everything runs at 56.67 MHz.
    - VgaTextOverlayDevice: new overlay device with same JOP bus register
    map as VgaText. 3-stage BRAM pipeline (charRam → fontRom → bit select).
    Background transparent, foreground text replaces Atari video.
    - VgaOverlayMux: rewritten as per-pixel compositor (overlayActive flag).
    - VgaFullScreenMux: extracted old full-screen switch for backward compat.
    - H/V text start positions configurable via registers 0xA/0xB (was
    compil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
2026-04-01 SD card FAT32 loading: Gyruss 16K cart from microSD, fix SPI mode entry
    - Add sd.init() and fs.mount(0) calls (were missing — root cluster was 0)
    - Drive SD DAT1/DAT2 high for SPI mode (card ignored CMD0 with floating lines)
    - Add DAT1 (B23) and DAT2 (B19) pin assignments with weak pull-ups in QSF
    - Load cartridge ROM from SD card FAT32: cartridge/Gyruss.rom -> SDRAM
    - Auto-detect 8K/16K cart size, set CART_MODE accordingly
    - Falls back to BRAM Star Raiders if SD card absent or mount fails
    - SPI clock: 56 kHz init, 3.5 MHz data (conservative for DB_FPGA traces)
    Tested: Gyruss 16K cart loads from 32GB SDHC FAT32 card and runs correctly.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
2026-04-06 SioBridge: hardware SIO UART bridge with interrupt + simulation tests
    Add SioBridge SpinalHDL component for JOP to monitor/inject Atari SIO bus:
    - S2P deserializer clocked by POKEY SIO_CLOCKOUT falling edge
    - P2S serializer with configurable baud divider (default 19200 @ 56.67 MHz)
    - 16-deep RX/TX FIFOs, COMMAND edge detection
    - Hardware interrupt on command frame completion (COMMAND rising + RX non-empty)
    Register as JOP device with interruptCount=1. Wire SIO signals (SIO_TXD,
    SIO_COMMAND, SIO_CLOCKOUT, SIO_RXD) through device pin infrastructure.
    Extend IoAddrGenerator to emit interrupt number constants (INT_SIOBRIDGE etc.)
    alongside device address constants. Replace hardcoded AtariCtrl a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
2026-04-06 SIO Phase 2: interrupt-driven command frame monitoring
    Register JOP interrupt handler for SioBridge (INT_SIOBRIDGE=4). On
    COMMAND rising edge, handler drains RX FIFO and prints command frame
    bytes to debug UART. Enables only SioBridge interrupt in mask.
    Expected output when Atari boots: "SIO:31 52 01 00 84" (D1: Read
    Sector 1 command frame from Atari OS disk poll).
2026-04-06 SIO Phase 3: disk drive emulator with protocol handling
    Add SioDiskEmu.java implementing SIO D1: drive emulation:
    - Command frame parsing (5 bytes from RX FIFO, checksum validation)
    - Read Sector (0x52): ACK -> read data -> COMPLETE -> data + checksum
    - Get Status (0x53): returns drive status (motor on, density, etc.)
    - Get Speed (0x3F): returns standard speed index
    - NAK on bad checksum or unknown commands
    - Proper SIO timing (T2=250us, T5=250us, T3=150us delays)
    Interrupt handler now sets cmdPending flag; main loop calls
    processCommand() which handles the full response sequence including
    TX FIFO management and busy-waits.
    Sector data reading is stubbed (returns zeros) — Phase 4 will ad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
2026-04-06 Phase 4: ATR disk image reading from SD card
    Mount ATR files from disk/ directory on SD card. SioDiskEmu now
    parses ATR headers and serves real sector data via Fat32RandomAccessFile.
2026-04-15 Phase 5: SIO disk boot from SD card — DOS 2.5 boots successfully
    Three hardware fixes enable reliable SIO disk emulation:
    - InternalRomRam: always instantiate cartridge BRAM (0xFF fill when empty)
    to stabilize Quartus P&R — removing BRAM shifted SPI signal routing,
    causing SD card CMD0 failures (R1=0x3F)
    - SioBridge: latch RX FIFO data on bus.rd to prevent JOP ioRdPending
    re-sampling from capturing the next FIFO entry after pointer advance
    - Atari800CoreSimpleSdram: CART_RD5=True when cartridge_rom is empty,
    so A000-BFFF maps to RAM instead of phantom 0xFF cartridge BRAM
    Also: cartridge_rom="" in DualPllTop (JOP loads carts from SD),
    waitTxDone checks P2S TX_BUSY bit, SD init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
2026-04-19 CH376T standalone test: FPGA bridge, USB keyboard, SD card scripts
    UART-to-SPI bridge FPGA design (ch376_test_top.sv) for CH376T bring-up
    on ATARI-800-LG-V1 board. Python test scripts for SPI verification,
    USB keyboard enumeration with HID polling, and SD card FAT32 filesystem
    access (mount, directory listing, file read).
    Found and documented SD card DI/DO wiring swap bug on prototype board.
2026-04-20 ATARI-800-LG-V1 board: VGA test + main build with VGA wiring
    Add standalone VGA color bar test (640x480@60Hz, 8 bars) verified working
    on hardware. Wire VGA outputs in main Atari+JOP wrapper (5-bit R/G/B DAC,
    green truncated from 6-bit SpinalHDL output). Add VGA pin assignments to
    main QSF. Add Makefile, .gitignore, board schematic, and output_files
    directory directive for all Quartus projects.
2026-04-26 ATARI-800-LG-V1: CH376T USB keyboard, audio, joysticks, console switches
    Full standalone Atari 800 on LG-V1 base board with QMTECH EP4CGX150:
    - Ch376UsbKeyboard: SPI bridge to CH376T for USB HID boot protocol keyboards
    - Pokey keyboard debug signals (IRQ pulse, held, enabled, pending, ACK)
    - Sigma-delta audio DAC with activity LED on base board LED 3
    - Joystick 1 & 2, console switches (Start/Select/Option/Reset)
    - VGA 5-5-5 via scandoubler, CH376T standalone keyboard test build
    - Shared Cyclone IV PLL wrapper (boards/cyclone4/atari_pll.sv)
    [atari_pll.sv]
2026-04-26 EP4CGX150 DualPll: SDRAM blanking gate, CH376T SD support, debug commands
    - SDRAM blanking gate: defer JOP requests to HBLANK/VBLANK to avoid ANTIC contention
    - CH376T block device driver (probe first, fall back to raw SPI SD card)
    - AtariSupervisor: memory peek (M), raw SPI transfer (X), clock divider (Y) commands
    - Disable VGA overlay before releasing Atari from reset
    - Atari800CoreSim: expose SIO pins and configurable internal_ram for simulation
2026-05-04 Reorganize boards/ — split per-project, separate base/core boards, common PLLs
    New layout pattern: boards/<base-board>/<core-board>/<project>/
    boards/common/ Shared per-FPGA-family entities
    cyclone4/atari_pll.sv (was boards/cyclone4/)
    cyclone10/atari_pll.sv (was boards/cyclone10/)
    boards/db_fpga_v4/qmtech-ep4cgx150/ EP4CGX150 + DB_FPGA v4 builds
    atari_ep4cgx150/ bare-metal (single-PLL, BRAM-only)
    atari_ep4cgx150_jop/ single-PLL JOP + CH376T
    atari_ep4cgx150_dualpll/ dual-PLL JOP + Atari + shared SDRAM
    boards/atari800-lg-v1/ LG-V1 base board
    ATARI-800-LG-V1-Schematic.{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
2026-05-04 .gitignore: cover .bloop/, simWorkspace/, *.bak, roms/, *.atr
    - Add .bloop/ (Scala IDE state, both root and project/) and project/metals.sbt
    - Add simWorkspace/ (camelCase variant — SpinalHDL writes this; existing
    sim_workspace/ rule didn't match)
    - Add *.bak (catches AtariSupervisor.java.bak and future backup files)
    - Add roms/ and *.atr alongside existing *.rom — copyrighted material,
    keep out of repo entirely
2026-05-06 db_fpga_v4 QSFs: apply path updates that were dropped during the rename
    The previous reorg commit (de70a46) recorded the three EP4CGX150 + DB_FPGA
    project QSFs as 100% renames, which silently kept the pre-edit content —
    the path updates and PROJECT_OUTPUT_DIRECTORY assignments I had made
    locally never landed. Re-apply them here:
    - ../../generated/ → ../../../../generated/
    - ../../jop-spinalhdl/ → ../../../../jop-spinalhdl/
    - atari_pll.sv (local) → ../../../common/cyclone4/atari_pll.sv
    - ../cyclone4/atari_pll.sv → ../../../common/cyclone4/atari_pll.sv
    - Add PROJECT_OUTPUT_DIRECTORY output_files
2026-05-06 Add ATARI-800-LG-V1.1 board layout, schematic netlist, and pin mapping
    V1.1 base-board layout: a single 128-pin connector U9 mating with the two
    32x2 headers of a QMTECH core board. Includes the KiCad-exported netlist,
    gerbers, BOM, 3D model, and assembly drawings.
    Generated U9-to-FPGA pin cross-reference (pin-mapping.md) for all three
    supported core boards (EP4CGX150, 10CL025, XC7A100T) and per-FPGA pin
    assignment scripts ready to source from a Quartus QSF or Vivado XDC:
    boards/atari800-lg-v1.1/
    ├── pin-mapping.md — full U9 → FPGA cross-reference
    ├── README.md — directory layout overview
    ├── ep4cgx150/v1_1_pins.tcl
    ├── 10cl025/v1_1_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
    [3DShell_3DShell_ATARI-800-QMTechCB-LG-V1_1_B.step, 3DShell_3DShell_ATARI-800-QMTechCB-LG-V1_1_T.step, BOM_ATARI-800-QMTechCB-LG-V1_1_ATARI-800-QMTechCB-LG-V1_1_2026-04-28.csv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]
2026-05-06 Add Atari 800 BRAM-only build for Colorlight i5 (ECP5 LFE5U-25F)
    New SpinalHDL top Atari800Ecp5BramTop wires the Atari core to the i5's
    4-bit VGA DAC, 1-bit sigma-delta audio, joysticks, console switches,
    keyboard scan/response, and SIO. Uses an EHXPLLL black box (25 MHz →
    37.5 MHz) defined in pll_ecp5.sv to drive cycle_length=21 for ~1.786 MHz
    6502 clock.
    The i5 board wrapper fit_check_top_ecp5.sv now instantiates this top.
    A `make generate` Makefile target invokes
    `sbt "atari/runMain atari800.Atari800Ecp5BramSv"`.
2026-05-06 Ch376KeyboardTestSv: update targetDirectory for new boards/ layout
    The boards reorg moved the CH376T standalone test project to
    boards/atari800-lg-v1/qmtech-ep4cgx150/ch376_test/ — point the SpinalHDL
    generator at the new path so `sbt runMain ... Ch376KeyboardTestSv` writes
    the SV directly into the project directory.
2026-05-06 Add Atari800DiskSimTb: SIO disk simulation with ATR image loader
    Standalone simulation testbench that drives the Atari core's SIO bus
    from a host-side ATR disk image. AtrFile parses the 16-byte ATR header,
    exposes sector reads, and the testbench feeds command/data frames into
    SIO_RXD on the simulated SIO bus.
    Companion to the SioBridge / SioDiskEmu work for hardware ATR boot.
2026-05-06 tools: add atari_peek.py and atari_peek_raw.py for JOP supervisor RAM peek
    atari_peek.py — formatted hex dump of Atari RAM via the JOP supervisor
    'M' command. Sends 'M' <addrLo> <addrHi> <lenLo> <lenHi> over the serial
    link and parses the AAAA: BB BB BB ... reply.
    atari_peek_raw.py — minimal raw read of the same command for protocol
    debugging when the parser misbehaves.
2026-05-06 tools: add pico_kbd_test — Pi Pico USB HID keyboard test fixture
    Standalone Pi Pico firmware (TinyUSB-based) that enumerates as a USB HID
    boot keyboard and emits scripted key sequences. Used to verify the
    CH376T USB-host implementation on the LG-V1 base board.
    CMakeLists.txt — Pico SDK CMake build
    main.c — keypress sequencer
    tusb_config.h — TinyUSB device-mode HID config
    usb_descriptors.c — USB descriptors (boot keyboard interface)
    Build artifacts (build/) are gitignored locally.
    [main.c, tusb_config.h]
2026-05-06 Add jop-atari.json: JOP supervisor configuration profiles
    Declares ROM/cartridge/disk path layouts for Atari boot variants. Loaded
    by AtariSupervisor at startup to decide which OS ROMs to map, which
    cartridge image to load, and which ATR disks to mount.
    Profiles:
    default — 800 OS + Star Raiders cartridge
    basic — 800 OS + BASIC cart + DOS 2.5 + MyDisk
    Paths are relative to the SD card root (e.g. /os/atariio2.rom).
2026-05-06 Bump jop-spinalhdl: XC7A100T doc fix + TROUBLESHOOTING + AlteraLpm sim variants
    Pulls in three submodule commits (rebased on top of upstream main):
    - XC7A100T board doc — fix off-by-2 in U2/U4 tables and peripheral
    J3/J2 pin numbers (loopback-verified UART pins as anchors)
    - TROUBLESHOOTING.md — 11-item debug checklist for JOP/Atari builds
    - AlteraLpm — aram_sim.vhd / arom_sim.vhd for BootMode.Simulation
    Replaces two earlier intermediate bumps (eb8ee3c, bd2eb41) which pointed
    at pre-rebase SHAs.
2026-05-06 README: comprehensive update for new boards/ layout and recent additions
    - Qualify the dualpll PMOD pin notes as DB_FPGA-specific; add LG-V1
    base-board wiring as an alternate path
    - Refresh Scala source list: add Atari800LgV1Top, Atari800Ecp5BramTop,
    Atari800DiskSimTb, Atari800JopSim/Tb, SioBridge, Ch376UsbKeyboard,
    VgaTextOverlayDevice, Mmu, CartLogic
    - Refresh tools/ list: add atari_peek*, ch376_keyboard/sdcard/spi tests,
    pico_kbd_test/, jop-atari.json
    - Expand boards/atari800-lg-v1.1/ subtree (pin-mapping + per-FPGA pin files)
    - Clarify ROM files section: roms/ is gitignored; document expected filenames
    - Add new build section for ATARI-800-LG-V1 base board (5 projects on
    EP4CGX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
2026-05-17 V1.1 bring-up: per-subsystem test projects for EP4CGX150 + 10CL025
    Adds 9 test projects per FPGA core, exercising each V1.1 base-board peripheral
    in isolation so each one can be confirmed working before the full Atari+JOP
    integration. All except SD card are verified passing on both cores; SD is
    broken on V1.1 (two data traces severed under U2, manually re-jumpered but
    not enough to recover) and is deferred to V1.2.
    Tests, in build-up order:
    led_test 8 base LEDs + core LEDs (power/clock/JTAG smoke test)
    uart_test 115200 8N1 loopback through CH340; FIFO-buffered echo
    ch376_test dual-bus UART-to-SPI bridge for KB + SD CH376Ts, 12 MHz PLL
    drives the chips' XI; ch37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
    [led_test.sv]
2026-05-18 V1.1 10CL025: full Atari 800 + Star Raiders + CH376 enum fix
    Boards: atari800-lg-v1.1/10cl025/atari_starraiders/
    - Thin SV wrapper around the existing SpinalHDL-generated Atari800LgV1Top
    - Maps V1 ports to V1.1 pin layout (8 base LEDs / 1 core LED instead of 4 / 2;
    KB CH376T routed to V1's single CH376 port; SD CH376T unused on V1.1).
    - Adds a dedicated ch376_pll (50 MHz → 12 MHz) to drive both CH376T modules'
    XI pin (V1.1 removes the crystal on each module — FPGA provides the clock).
    - Targets BRAM-only (40K RAM + 8K cart + 10K OS = 58 of 66 M9K). Star Raiders
    cartridge ROM ships in the existing Atari800LgV1Top configuration.
    On-bench result: Atari 800 boots, Star Raiders title s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
    [atari_starraiders.sv]
2026-05-20 Add 10CL025 board doc; V1.1 10CL025 setup README
    Bumps jop-spinalhdl to pick up the new qmtech-10cl025-board.md (FPGA
    spec, pinout, gotchas, SDRAM pinout). Adds a per-FPGA README under
    boards/atari800-lg-v1.1/10cl025/ that lists the bring-up projects and
    links to the board doc on GitHub.
2026-05-20 Add RP2040-STAMP-HDMI-LG base board pin mapping
    New alternative base board: QMTECH 10CL025 only, RP2040-STAMP for USB
    host + supervisor + paddle ADC, HDMI replacing VGA resistor DAC,
    optional Raspberry Pi Radio Module 2 on FPGA SPI, SD card on FPGA
    SDIO. Drops CH376T USB hosts, MCP3208 ADC, IS63LV1024L SRAM, and
    base-board LEDs from V1.1.
    pins.tcl: 4 TMDS pairs on bank-4 DIFFIO (B17/B18/B20/B23) at U4.7-20,
    audio, console switches, RM2 SPI, SD SDIO, joysticks, RP2040↔FPGA SPI
    link + 13-line GPIO bus, onboard SDRAM. Net names sourced from the
    KiCad-exported netlist Netlist_*-2026-05-20.enet.
    pin-mapping.md: full U4 → FPGA pin → net cross-reference plus
    RP2040 control-flow notes and si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
2026-05-20 RP2040-STAMP-HDMI-LG: preproduction Atari + HDMI fit verified
    Adds the first synthesizable design for the new alternative base board.
    SpinalHDL top reuses the existing Atari800CoreSimpleSdram (BRAM, Star
    Raiders, 800 OS) and replaces the V1.1 VGA pipeline with the restored
    DvidOut TMDS encoder + 5×/DDR serializer feeding HDMI via four bank-4
    DIFFIO pairs. RP2040↔SD-card and RP2040↔RM2 SPI pass-throughs wire
    through with direct combinational routing for the sanity check; CH376T
    keyboard FSM and base-board LEDs removed.
    Quartus 25.1 result on the QMTECH 10CL025 (10CL025YU256I7G):
    Fitter Successful, SOF written
    LE 7,633 / 24,624 (31%) — 1.6k fewer than V1.1 baseline
    M9K 504,336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
    [atari_pll.sv, atari_starraiders.sv]
2026-07-01 Fix DvidOut TMDS clock word (malformed clock blocked HDMI lock)
    The clock-channel serializer was loaded with shiftCH=B"01010", which
    through the 5x DDR interleave serialised to 0111001000 — not a valid
    half-rate clock, so no HDMI sink could lock (blank screen). Correct
    value is B"00111" (with shiftCL=B"00011"), giving a clean 1111100000
    clock, matching the reference DVI encoder.
    Verified on hardware: Atari 800 + Star Raiders now displays over HDMI
    on the ATARI-800-QMTechCB-RP2040-STAMP-HDMI-LG + QMTech 10CL025 board.
2026-07-01 Add WIP HdmiLineBuf de-jitter scan-converter (not wired in)
    Dual-clock 2-line buffer that re-clocks the scandoubler's sys-domain
    video (~28.8 MHz-paced) into the 25 MHz HDMI pixel domain to remove the
    async-sampling shimmer, with per-line genlock and a nearest-neighbour
    horizontal DDA. Stored 12-bit RGB444 to fit the 10CL025's M9K budget.
    v1 does not lock yet: its self-generated output raster assumes ~525
    lines/60 Hz while the source is PAL (~630 lines/50 Hz). Needs a SpinalHDL
    simulation testbench to debug the raster/genlock before re-wiring. Left
    unwired; the top keeps the direct (working, slightly shimmery) DvidOut
    hookup.
2026-07-02 Stage 1: run Atari RAM from SDRAM (SdramStatemachine, sole master)
    internal_ram=0 — all Atari RAM now lives in SDRAM (OS/cart still BRAM),
    freeing ~370 Kbit of BRAM (91%->30%). Adds a 2nd PLL (QMTech pll.v, 100 MHz)
    for CLK_SDRAM, wires the core's SDRAM_* interface to SdramStatemachine
    (AC608 pattern) with a 16-bit tristate DQ, and sequences reset: RESET_N held
    through a power-up counter + CPU HALT until reset_client_n so first RAM
    accesses don't hit uninitialised SDRAM.
    Clock crossing hardened: the SDC set_clock_groups filter (*pll1|clk[0]) had
    been matching BOTH PLLs' clk[0], grouping the 57.69 MHz sys and 100 MHz SDRAM
    clocks as related (marginal/intermittent). Now filtered on instance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
    [atari_starraiders.sv]
2026-07-02 Add SDRAM bring-up test project (Stage 0)
    Standalone, reusable SDRAM smoke test for the QMTech 10CL025: SdramTestTop
    (SpinalHDL) drives SdramStatemachine @100 MHz via the QMTech-proven pll.v,
    autonomously writes+reads-back 16384 words and reports on led_core by blink
    rate (fast=PASS, slow=FAIL, steady=stuck). Verified PASS on hardware — the
    foundation that unblocked Stage 1.
2026-07-02 Stage 2: framebuffer write path + simulation
    VideoFbWrite (SpinalHDL): captures the Atari video (8-bit GTIA colour index +
    hsync/vsync/blank) and writes each active pixel into a linear SDRAM framebuffer
    (addr = fbBase + y*stride + x), with a StreamFifo decoupling the bursty pixel
    capture from per-word SDRAM writes. Sim-verified by VideoFbWriteSimTb (SpinalSim
    with a behavioral SDRAM-write sink): 32/32 pixels correct, blanking skipped,
    Y indexing correct. First increment of the SDRAM-framebuffer 720p scaler.
2026-07-02 Stage 2: framebuffer read/scaler path + simulation
    VideoFbRead (SpinalHDL): reads the SDRAM framebuffer and scales it to the output
    raster with nearest-neighbour H/V upscale. Two ping-pong BRAM line caches — the
    fetch engine loads the next output line's source row into one cache while the
    active line is served from the other, so SDRAM sees ~one source-row read per
    output line (~a few MB/s), not the full 720p pixel rate. Dual-axis DDA does the
    nearest-neighbour mapping; outputs registered to align with the cache read.
    Sim-verified by VideoFbReadSimTb (SpinalSim, behavioral SDRAM read model): an
    8x4 source upscales to 16x12 output with exact values/alignment (errors=0).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
2026-07-02 Stage 2: 3-port SDRAM arbiter + faithful sim
    SdramArbiter3 (SpinalHDL): extends the proven 2-port arbiter to three masters —
    A (Atari core, zero-latency priority passthrough), B (fb-write), C (fb-read),
    B and C queued and served when A is idle. Only one of B/C active at a time.
    Verified against MockSdram, an RTL model of SdramStatemachine's client toggle
    handshake (COMPLETE = (reply==req) & ~REQUEST) with a fixed-latency byte memory
    — compiled with the DUT so there's no TB delta-skew (an earlier TB-side model
    gave false failures). SdramArbiter3SimTb (via Arb3Harness = arbiter + MockSdram)
    passes: A R/W, B-write read back through C, and a concurrent A/B/C burst, all
    correct (errors=0). M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
2026-07-02 Stage 2: full framebuffer pipeline integration sim
    FbPipeline harness wires the whole data path in one clock domain:
    video -> VideoFbWrite -> SdramArbiter3(port B) -> MockSdram, and
    MockSdram -> SdramArbiter3(port C) -> VideoFbRead -> scaled video-out
    (Atari port A tied off). FbPipelineSimTb drives a source frame in, lets it
    land in SDRAM through the arbiter, then captures a read-side frame and verifies
    the write->SDRAM->read->upscale round-trip: 8x4 source -> 16x12 output, exact
    (errors=0), no FIFO overflow. Proves the Stage 2 modules work together.
2026-07-02 Stage 2: dual-clock framebuffer read/scaler (VideoFbRead2)
    Hardware version of the read/scaler split across two clocks: output timing +
    H-DDA + cache read + pix on clkPixel (720p), fetch engine + cache write +
    SDRAM read port on clkFetch (arbiter/SDRAM domain). Dual-clock BRAM line cache
    (clockCrossing read) + a per-line toggle/2-FF handshake carry the source-row
    request/done across domains (line rate ~45 kHz, so 2-FF sync is ample).
    Verified by VideoFbRead2SimTb with pixel and fetch clocks at different async
    periods: nearest-neighbour upscale exact (errors=0), no clock-crossing
    violations. Same scaling as the sim-proven single-clock VideoFbRead, now CDC-safe.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
2026-07-02 Stage 2 integration: Atari HDMI via SDRAM framebuffer 720p scaler
    Rewire Atari800Rp2040HdmiLgTop to route video through the SDRAM framebuffer:
    - SdramArbiter3 merges Atari RAM (port A) + framebuffer write (B) + read (C)
    into the one SdramStatemachine.
    - VideoFbWrite captures raw Atari video (VIDEO_B index + HS/VS/BLANK) to SDRAM.
    - VideoFbRead2 (dual-clock: fetch @57.69 MHz, output @74.25 MHz) reads + scales
    to 1280x720, then GtiaPalette -> DvidOut (371.25 MHz TMDS). Scandoubler dropped.
    - New PllHdmi (pll_hdmi.v) for 74.25/371.25; SDC declares the HDMI clock domain
    asynchronous to sys/SDRAM.
    Timing fixes found via build: replaced VideoFbRead2's vertical divider with a
    DDA (the oy*src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
2026-07-03 720p framebuffer display path debugged on hardware: rock-solid checkerboard
    Hardware bring-up of the Stage 2 pipeline found five real bugs, each
    reproduced (where possible) in simulation before fixing, and verified on
    silicon with the RP2040 logic analyzer (gusmanb firmware, driven over
    /dev/ttyACM0 by a Python client speaking its binary protocol):
    - Sync polarity: 720p timing needs ACTIVE-LOW hs/vs (per the proven
    disp_driver); active-high never locked the monitor. Also swapped DvidOut
    for the corecourse dvi_encoder blackbox (DviEncoder.scala + dvi_encoder.v).
    - Reset skew: the BOOT-reset pixel/fetch domains fire the first read request
    microseconds after config, while the arbiter (sy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
    [dvi_encoder.v]
2026-07-03 Real Atari video at 720p + deterministic SDRAM interface
    Capture path (VideoFbWrite + top):
    - Sample at the real Atari hi-res pixel rate (sys/8 ~7.2 MHz, hsync-phased);
    colourEnable (sys/2) was 4x too fast and squashed the image into the left
    quarter of the 384-wide buffer.
    - Pack 4 pixels per 32-bit SDRAM write (byte writes could not drain the pixel
    rate once fb-reads took priority; ragged line ends from FIFO drops).
    - Clear the framebuffer to black once after every reset (stale-content strip).
    - Console-reset robustness: fbRead aborts in-flight fetches and resyncs the
    ring when enable drops; fbWrite is enable-gated the same way.
    - Gate both fb clients on the controller's reset_clie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
2026-07-04 Widen SDRAM read-capture margin: chip clock lead 2.0 -> 2.4 ns
    DQ input setup slack was +0.069 ns at the slow corner - functional but
    uncomfortable, and the remaining occasional panel jitter correlated with
    rare single-window capture-row flips on the LA probe. With +0.611 ns the
    probe shows 9/9 clean 120 ms gameplay windows (row never moves).
    [atari_pll.sv]
2026-07-04 Supervisor phase 1: USB keyboard -> RP2040 -> SPI -> Atari, working end to end
    FPGA side (all SpinalHDL, sim-first):
    - AtariHidMap: the proven HID->Atari matrix table extracted from
    Ch376UsbKeyboard (V1 board) into a shared object.
    - RpAtariKeyboard: SPI-slave bridge on the dedicated RP2040 link
    (mode 0; 'K' + raw 8-byte HID boot report committed atomically at CS
    rise; 'C' + control bits for reset/start/select/option overrides; MISO
    returns 0xA5 + frame counter for link checks). Same KEYBOARD_RESPONSE
    generation as the CH376 path. 5-test ScalaTest spec (matrix mapping,
    shift/ctrl regions, release, console keys, partial-frame rejection).
    - Top: replaces the KEYBOARD_RESPONSE stub;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
    [main.c, tusb_config.h]
2026-07-04 Supervisor phase 2: SD card reading through the FPGA passthrough
    - FPGA: rp_gpio12/14 returned from LA debug duty to their designed SD
    passthrough roles (DAT0/MISO and card-detect to the RP2040).
    - Firmware: SPI-mode SD driver on SPI1 (GPIO10-13 exactly match the
    controller pinout; 400 kHz init, 4 MHz data - conservative through the
    combinational FPGA passthrough), CMD0/8/ACMD41/58 init with SDHC
    detection, CSD capacity, single-block read/write.
    - FatFs R0.15 vendored (public domain; CP437, LFN enabled, no RTC) with a
    thin diskio binding. Console: i = card init/info, d = mount + list root.
    Verified on hardware: 32 GB SDHC detected and read; FAT32 mounts; root
    listing shows the pre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
    [main.c, sd_diskio.c, sd_spi.c, sd_spi.h]
2026-07-04 Supervisor SDRAM load channel: SD -> SPI -> arbiter port D -> SDRAM, verified
    - SdramArbiter3 gains port D (supervisor loader, lowest priority - below
    the Atari, fb-read and fb-write; future disk hot-loads can run with the
    core alive). Harnesses stub it; arbiter sim still passes.
    - RpAtariKeyboard SPI protocol grows 'W' (24-bit SDRAM address + streamed
    data, packed 4 bytes/32-bit write, little-endian like the rest of the
    system) and 'Z' (zero the load byte-counter and 16-bit checksum). MISO
    status now returns 0xA5, frameCount, count.lo/hi, sum.lo/hi so loads
    are verified without a read channel. byteIdx widened to 12 bits for
    long frames. Spec: 7 tests (adds quad-exact loader wr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
2026-07-04 Supervisor: real SD file loaded into SDRAM with verification
    - cdc_printf pumps tud_task while draining (64-byte CDC TX FIFO truncated
    long lines); USB heartbeat only logs device-count changes.
    - Verified on hardware: /cartridge/Galaxian.rom (8 KB) loaded from FAT32
    to SDRAM 0x300000, FPGA checksum e87f == local -> OK.
    Atari address recipes for the ROM-from-SDRAM increment (from Peter):
    atarios2.rom (2K) -> $D800-$DFFF
    atariosb.rom (8K) -> $E000-$FFFF
    8K cartridges -> $A000-$BFFF
    16K cartridges -> $8000-$BFFF
2026-07-05 WIP: ROM-from-SDRAM diagnostic state (boots at 0x110000, fails above 0x124000)
    Where this stands after a long forensic session:
    PROVEN WORKING on hardware:
    - The complete boot mechanism: with the OS window placed INSIDE the
    framebuffer region (0x110000), the machine BOOTED from SD-loaded OS
    (screen flashed alive, then the fb capture overwrote the OS - expected
    for that diagnostic placement). Decode, port-A fetch, reset flow: all fine.
    - Loader byte-writes verified visually (fb region) and by stream checksums.
    - CPU issues correct OS-window addresses (probe: 0x...FFC/FFD after reset).
    - Full-topology simulation (core + arbiter + toggle-protocol MockSdram +
    15-cycle latency) boots cle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
    [main.c]
2026-07-05 Full-range SDRAM BIST: chip is 9-bit-column 32MB; full test PASSES at 100 MHz
    The Stage-0 test only covered 32 KB. New SdramBistEngine + BistSpiReporter
    (SpinalHDL, sim-tested incl. structural alias injection) runs against the
    real SdramStatemachine: address-bit walk to 16 MB, two full 32 MB sweeps
    with address-unique data, and a 1.3 s refresh-retention re-read. Status
    over RP2040 SPI (supervisor 'm' poll / 'M' restart+follow), LED heartbeat.
    Hardware results:
    - COLUMN_WIDTH=10 (QMTech Test04 geometry): FAIL in walk phase - write to
    0x400 clobbers 0x0, i.e. the chip ignores column A9. Wrong for this module.
    - COLUMN_WIDTH=9 (original): PASS, 0 errors, all 32 MB, all phases.
    So chip/modul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
    [main.c]
2026-07-05 SdramStatemachine datasheet fixes; BIST passes 32MB at BOTH clock configs
    Review findings (W9825G6KH-6 datasheet, cross-checked against the original
    MiST VHDL) fixed in the controller:
    - Refresh interval 2048 -> 750 cycles: the chip needs one refresh per 7.8us
    (8192/64ms); the inherited constant gave 17.7-20.5us at our clocks.
    Explains rows written once decaying while re-accessed rows (RAM, fb, and
    the OS-in-framebuffer boot) survived on activation refresh.
    - MRS reserved bits: addr_next defaults to all-ones and the mode-register
    code only cleared bits 10-11, so ROW_WIDTH=13 drove A12 HIGH during MRS
    (datasheet: reserved bits must be 0). Now clears ROW_WIDTH-1..10.
    - Power-up pause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
2026-07-05 FIRST BOOT from SD-loaded SDRAM ROM: halted load + FPGA content verify
    The Atari boots to the memo pad with the OS loaded from SD card into SDRAM
    (window 0x140000) - the no-ROMs-in-bitstream goal works end to end.
    Two changes closed the last load-integrity holes:
    - 'C' frame bit 4 drives the 6502 HALT input: the supervisor halts the
    Atari for the whole load+verify window. Previously the crashed CPU
    hammered port A while the loader sat on the lowest-priority port with a
    single-buffered write register - long arbitration stalls could drop
    loader bytes invisibly to the stream checksum.
    - New 'V' SPI command: the FPGA reads N bytes back from SDRAM through the
    loader port (byte mode - t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
    [main.c]
2026-07-05 Loader hardened: (addr,data) FIFO + drain accounting; 10/10 verified boots
    The SPI loader now queues every W byte as an (address, data) pair in a
    512-deep FIFO - arbitration stalls deepen the queue instead of clobbering
    a single buffer - and counts completed drain writes. Status bytes expose
    content sum, vBusy, FIFO-overflow sticky, and the drain counter; the boot
    flow verifies CONTENT after every load and retries a corrupt file up to 3x.
    Isolation testbeds built along the way (all PASS at 115.38 MHz, IOE, main
    SDC): BIST via arbiter port D longword; byte mode; byte + continuous
    refresh-suggest; byte + concurrent ANTIC-cadence port-A reads. Engine gained
    byteMode + a phase-4 hash fix; arb t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
    [atari_pll.sv, color_bar.v, disp_driver.v, disp_parameter_cfg.v, dvi_encoder.v, dvid.sv, hdmi_color.v]
2026-07-05 Wide (256-bit) framebuffer path end to end: fb starvation 65535/2s -> ZERO
    VideoFbRead2: 256-bit fetches (fetchBytes param, legacy 4-byte mode kept
    for the existing spec matrix) - a source line is 12 wide reads instead of
    96 singles. VideoFbWrite: drain batches 8 sequential quads into one wide
    write, with a singles-flush fallback for gaps/tails (spec-proven both
    ways). SdramArbiter3 + MockSdram + harnesses plumbed for wide B/C.
    Sim: 26/26 tests green including a wide-configuration scaler test and the
    new VideoFbWriteSpec batching tests.
    Hardware: boot verified byte-exact as before; fb meters late=0 drop=0
    after 12 s of running (previous build saturated both 16-bit counters
    within 2 s). The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
2026-07-05 ARCHITECTURE.md: system write-up for the RP2040-HDMI-LG board
    Vision, block architecture, memory map, the wide-access transaction
    economics, the supervisor protocol, the bring-up instrument suite, and
    the ten stacked defects behind the ROM-from-SDRAM black-screen phase -
    each with its lesson. Written at the first verified SD-boot milestone.
2026-07-06 supervisor: re-present USB device before main loop so it enumerates cold
    The CDC console (cafe:4002) failed to enumerate on cold power-up and
    needed a physical replug. Cause: tud_init() asserts the USB pull-up and
    presents the device immediately, but tuh_init() (PIO-USB host) and
    fpga_spi_init() then run without pumping tud_task() — a host that begins
    enumeration in that window gets no response to its control transfers and
    gives up until the device physically disconnects. Replugging worked only
    because by then the main loop was pumping tud_task().
    Fix: after all init, right before the main loop, tud_disconnect() /
    sleep / tud_connect(). The host sees a fresh connect against a stack that
    n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
    [main.c]
2026-07-06 Centre the picture: measured capture-window offset, default-baked, reset-proof
    The 384x288 framebuffer captured the Atari picture offset (measured bbox:
    320x192 content at top margin 69 / bottom 27 — shoved down ~42 rows), so
    the memo pad sat high-left with uneven borders.
    Added a per-frame content bounding-box probe to VideoFbWrite (first/last
    bright row & column), read over the console ('G'): the exact numbers that
    turned guessing into a one-shot fix. Standard playfield origin is fixed
    across graphics modes, so a single offset centres them all.
    Capture-window offset (hStart right-shift, vSkip top-skip) added to
    VideoFbWrite, set over SPI ('G' 0x47, console 'o <h> <v>'). Defaults
    hStart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
    [main.c]
2026-07-06 Cart-from-SDRAM, triple buffer, pixel-clock-locked capture
    Session wins, all hardware-tested:
    - Cart-from-SDRAM on the flat map: Star Raiders 8K loads to $A000,
    content-verified, boots (sim-proven in Atari800CartBootSimTb: CPU runs
    in the cart pages). CartLogic mode via supervisor 'X' (BOOT-domain reg,
    survives reset); firmware loads /cartridge/Star Raiders.rom by default.
    AddressDecoder cart blocks read flat (removed sdramCartAddr shadow).
    - Triple-buffered framebuffer: fixes the 50<->60 Hz boundary tear (Atari
    50 Hz PAL write vs 720p 60 Hz read on a single buffer). Reader-faster
    needs 3 buffers; writer cycles 0->1->2, reader reads last-completed,
    latched per display frame. Co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
    [main.c]
2026-07-07 Fix display jitter: Atari 48KB RAM in BRAM (internal_ram=49152)
    The root cause of the whole-picture per-frame "jitter" (chunky ~32px shear,
    different every frame) was ANTIC's real-time display DMA - screen memory and
    display list - arriving late because RAM shared the one SDRAM with code fetches
    (internal_rom=0) and the 256-bit wide framebuffer bursts. A wide burst blocks
    port A ~46 sys-cycles, over one Atari machine cycle (~32), so ANTIC stalls
    mid-scanline and the line shears. Disproven along the way (by elimination on
    hardware): refresh rate, triple-buffer buffer-select CDC, and the capture
    strobe - none of them.
    Fix: put the Atari's 48KB RAM in BRAM. It's blank, so nothing proprietary
    e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
2026-07-07 Step 1: supervisor loads the 800 OS into blank BRAM from SD
    The OS no longer lives in SDRAM (nor embedded in the .sof). New load path:
    - InternalRomRam internal_rom=5: the 800 OS (D800-DFFF + E000-FFFF) as blank,
    writable GenericRamInfer blocks instead of embedded FileRom. Writes get a
    2-cycle busy->done edge so the streaming loader's handshake sees it.
    - Atari800CoreSimpleSdram: a LOAD port (enable/target/addr/data/we/req/complete)
    muxed into RAM_ADDR/ROM_ADDR/*_WRITE_ENABLE/PBI_WRITE_DATA post-decoder, so the
    supervisor drives the BRAM directly while the Atari is HALTed. Supervisor
    supplies the rom-space address (D800->0x1800, E000->0x2000).
    - RpAtariKeyboard: 'B' (0x42) SPI comm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
    [main.c]
2026-07-07 Step 2: cart into the shared top-of-RAM BRAM (read-only)
    The cart no longer lives in SDRAM either - it loads into the same RAM BRAM that
    backs A000-BFFF (which it overlaps), read-only while active:
    - Firmware loads the cart via ldDest=2 (RAM BRAM) at A000, then sets cart mode.
    - AddressDecoder: the emuCart region ($8000-9FFF / $A000-BFFF) now reads
    io.ramData (the RAM BRAM holding the cart) instead of io.sdramData, and
    swallows writes (read-only ROM cart). RD5 stays asserted so the 800 OS still
    detects and boots the cartridge - so the supervisor cart-select IS the
    read-only control, as requested.
    - Core: LOAD completion moved to a 2-cycle busy->done in the load path so it
    works for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
    [main.c]
2026-07-07 Step 3: sever Atari<->SDRAM path; SDRAM is framebuffer-only
    With RAM+OS+cart all in BRAM (Steps 1-2), the Atari never issues an SDRAM access
    (verified on hardware: port-A maxStall=0, fb meters late=0 drop=0). So:
    - Port A data path tied off (request/rw/addr/data = 0); only its refresh input
    is kept, driving framebuffer retention. Atari SDRAM_REQUEST_COMPLETE self-
    completes any stray request (can't hang); SDRAM_DO = 0.
    - Port D (loader->SDRAM) severed; OS/cart load into BRAM via the core LOAD port.
    ldDest=0 self-completes as a no-op.
    SDRAM now carries only the framebuffer (capture write B / display read C). The
    whole contention class that caused the sprite smear AND the display jitter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
2026-07-07 Add STATUS.md: handoff snapshot (Atari fully in BRAM, SDRAM framebuffer-only)
2026-07-10 Config-driven boot, SIO disk emulator, and supervisor menu
    Config-driven boot (firmware/supervisor/config.c): parse the SD JSON
    hierarchy (/config.json -> machine config -> cart + disks) into a
    boot_config_t; do_boot() is now driven by it instead of hardcoded paths,
    and runs automatically at power-on. Hardware-verified.
    SIO disk emulator: port the JOP SioDiskEmu to the RP2040 driving the
    existing SioBridge hardware serializer over the SPI link. RpAtariKeyboard
    gains two SPI commands - 'Q' (SIO reg write) and 'S' (SIO reg read, result
    in MISO status bytes 24/25); the top wires SioBridge to the core SIO bus.
    firmware/supervisor/sio.c parses command frames and streams ATR sectors
    (READ_SECTOR/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
2026-07-10 Update docs to current state; RP2040 JTAG IDCODE bring-up
    Docs:
    - STATUS.md: rewrite to current state (config-driven auto-boot, SIO disk
    emulator with Jumpman confirmed, Alt-F12 supervisor menu); JTAG loader as
    next milestone.
    - README.md: add Acknowledgements (TinyUSB, Pico-PIO-USB, FatFs, Pico SDK,
    SpinalHDL, dirtyJTAG) and a current-focus pointer to the RP2040 board.
    JTAG bring-up (firmware/supervisor):
    - jtag.c/.h: bit-bang JTAG master on GPIO0-3 (TMS/TCK/TDI/TDO), base header
    J10 -> QMTech module programming header. Reads the 32-bit FPGA IDCODE
    (TLR -> Shift-DR -> 32 bits LSB-first) to prove the wiring before layering
    on the Quartus-facing USB-Blaster emulation personality.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
2026-07-10 RP2040 USB-Blaster emulation: Quartus programs the FPGA directly
    The supervisor now presents a composite USB device (09fb:6001) that is an
    Altera USB-Blaster AND the CDC console at once (like an FTDI dual-channel
    part), so Quartus / quartus_pgm program the FPGA .sof over the RP2040's
    GPIO0-3 -> J10 JTAG link — removing the Altera Blaster dependency — while the
    supervisor console keeps working. One stable identity (no mode switching).
    Ported from ~/pico-usb-blaster (MIT: debugged RP2040 Blaster + FTDI emulation):
    - blaster.c/.h: JTAG-only Blaster protocol on GPIO0-3. Bit-bang shift at
    ~500 kHz (the reference's delay-free shift gave "chain broken" over the J10
    flying leads; jtag.c's p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
    [blaster.c, blaster.h, ft245_eeprom.h, main.c, tusb_config.h]
2026-07-10 Blaster: PIO JTAG shift (6 MHz) + descriptive device name
    - blaster_jtag.pio: 2-instruction PIO shift (4 cycles/bit, side-set TCK,
    out TDI, in TDO, autopull/push at 8 bits, TDO input-sync bypass).
    - blaster.c: place the shift on a spare SM (tries pio0 then pio1 alongside
    PIO-USB; falls back to the ~500 kHz bit-bang if neither has room). TCK at
    6 MHz (clkdiv 5 @120 MHz) — the real-Blaster rate, which holds over the J10
    flying leads. shift_enter/exit_pio swap TCK/TDI between PIO (shift) and SIO
    (bit-bang TAP navigation).
    - Result: quartus_pgm 73 s -> 32 s, 0 errors; now bound by USB FS bulk
    scheduling rather than shift speed. PIO-USB + console unaffected.
    - usb_descriptors.c: ren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
    [blaster.c]
2026-07-10 Supervisor: expose the SD card as a USB drive (MSC)
    Adds a 4th USB function to the composite device so files/configs can be
    dropped and edited on the SD card from the host without pulling it. Device
    now: interface 0 vendor (USB-Blaster), 1-2 CDC console, 3 mass storage.
    - msc_disk.c: TinyUSB MSC callbacks backed by sd_read_block/sd_write_block
    (the same primitives FatFs uses). All SD access is single-core cooperative,
    so block transactions are serialised — no SPI corruption from two masters.
    - Dual-writer FAT safety: the drive is reported write-protected while a disk
    is mounted for SIO (tud_msc_is_writable_cb -> !sio_any_mounted). Read
    anytime; write when the Atari is idle/cart-on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
2026-07-10 Supervisor: SD-side FPGA loader (configure the FPGA from SD, no host)
    The RP2040 now configures the FPGA from /fpga/core.rbf on the SD card over its
    JTAG link (GPIO0-3 -> J10) with no host and no Altera Blaster.
    - fpga_config.c/.h: Cyclone JTAG configuration ported from
    ~/pico-usb-blaster/program_fpga.c (IR_CONFIG -> shift .rbf -> STARTUP/BYPASS
    -> CONF_DONE), driving JTAG by feeding the same Blaster bytes into the proven
    blaster_process() engine.
    - Flash staging: the SD card is reached *through* the FPGA passthrough, so it
    goes offline during reconfiguration and the 700 KB .rbf won't fit in RAM. The
    .rbf is therefore staged into a reserved RP2040 flash region (1 MB in) and the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
    [fpga_config.c, fpga_config.h, main.c]
2026-07-10 FPGA core image lives with the machine config (/atari/800/core.rbf)
    Move the SD-side FPGA image out of a separate /fpga dir into the machine
    definition, alongside its config.json/os/cartridge/disks. The staging step now
    resolves the path through the config hierarchy (config_fpga_path: /config.json
    "default" machine dir -> <machine>/core.rbf) instead of hardcoding /fpga.
    - config.c/.h: add config_fpga_path() (reads only /config.json, cheap enough
    for the pre-USB staging step).
    - main.c: stage <machine>/core.rbf.
    Verified: staging reads /atari/800/core.rbf (718569 bytes) via the config path.
    [config.c, config.h, main.c]
2026-07-10 Supervisor: wait for the SD card before staging the FPGA core
    On a cold power-on the FPGA is still loading from config-flash, so the SD card
    (reached through the FPGA passthrough) isn't ready for the first few hundred ms
    — the single-attempt staging step silently skipped, logging "0 bytes". Retry
    sd_init + mount for up to 2.5 s so staging runs once the FPGA/SD are up (matches
    what do_boot effectively does later). Distinguishes "no image on SD" from "SD
    not ready" in the log.
    Warm-reset verified (stages immediately); cold-boot race is the case this fixes.
    [main.c]
2026-07-10 Top: complete the RP2040<->RM2 SPI passthrough (MISO + IRQ return lines)
    The RP2040->RM2 lines (SCK/MOSI/CS/WIFI_ON/BT_ON) were wired, but the two
    RM2->RP2040 return lines were still carrying framebuffer bring-up debug, so the
    RP2040 could talk to the Radio Module 2 (CYW43439) but not hear it. Route
    rm2_miso -> rp_gpio22_out and rm2_irq_n -> rp_gpio24_out to complete the
    bidirectional passthrough, enabling RP2040 gSPI access to the chip. The freed
    debug taps (fb dropped-quad, fb-read busy) are no longer needed.
    Regenerated, built (0 errors), and programmed via the RP2040 Blaster; Atari
    re-boots fine on the updated bitstream.
2026-07-10 Firmware: RM2 (CYW43439) connectivity smoke test
    Bit-bangs the Radio Module 2's gSPI through the FPGA passthrough (RP2040 GPIO
    20=SCK/21=MOSI/22=MISO/23=CS/5=WIFI_ON/4=BT_ON): powers the chip via WIFI_ON and
    reads its test register (bus function reg 0x14, with the driver's reset-time
    16-bit-half swap), expecting 0xFEEDBEAD. Console 'W'.
    Hardware-verified: "rm2: test reg = feedbead -- ALIVE" — confirms the RP2040 <->
    FPGA <-> RM2 SPI path (both directions) and that the chip powers up. (Mode-0
    phase: sample MISO before the rising SCK edge; sampling after gave feedbead<<1.)
    Foundation for porting the Pico SDK cyw43-driver (same chip) for WiFi/BT.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
    [main.c, rm2.c, rm2.h]
2026-07-10 On-screen supervisor: RP2040 renders into the SDRAM framebuffer -> HDMI
    Hw-assist so the RP2040 can draw the supervisor UI on HDMI:
    - RpAtariKeyboard: new control bit 5 = supDisplay (ctrlBits widened to 6 bits).
    - Top: re-enable arbiter port D as the RP2040 -> SDRAM write path (loader,
    ldDest 0, 32-bit longword access) -- idle unless the RP2040 is loading, so it
    doesn't disturb normal Atari-in-BRAM operation. When supDisplay is set, freeze
    the Atari video capture and point the display (VideoFbRead2) at buffer 2
    (fbBase + 2*0x40000 = 0x180000), the buffer the RP2040 renders into.
    - Firmware 'V': fill buf2 with a colour-band test pattern via the loader.
    Hardware-verified: 'V' shows ho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
    [main.c]
2026-07-10 On-screen supervisor: text rendering (8x16 font -> HDMI)
    - Fix port D access mode: the loader is byte-granular (one byte per request at
    its address, replicated across lanes), so use byte access, not longword.
    Longword access aligned each byte's write to a 4-byte group and collapsed it,
    scrambling pixels into 4-wide blocks; byte access lands each pixel exactly.
    - font8x16.h: the project's own 8x16 overlay font, extracted from
    VgaTextOverlayDevice.scala into a C table.
    - fbtext.c/.h: a 48x18 character grid rasterised into the SDRAM supervisor
    buffer via the loader (fpga_fb_begin/write in main.c/boot.h).
    - main.c 'V': render a sample menu screen (title, info, font sample).
    Hardware-v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
    [boot.h, fbtext.c, fbtext.h, main.c]
2026-07-10 Supervisor menu on HDMI: render the live menu into the framebuffer
    Wire the render-agnostic supervisor menu to an on-screen backend so it shows on
    HDMI (not just the console): sup_enter now sets halt+supDisplay (0x30) and
    fb_render() mirrors the current menu/picker state into the SDRAM supervisor
    buffer via fbtext. Navigation redraws on screen.
    - fbtext_flush now writes the full 512-byte stride so the 128-px line padding is
    cleared to background (was leaking the old Atari frame).
    - fpga_fb_verify(): checksum the loader writes to detect queue-overflow drops.
    Verified drops = NONE, so the framebuffer content is correct; the residual
    jitter / stale-blue is the display read path (scaler l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
    [boot.h, fbtext.c, main.c, supervisor.c]
2026-07-11 Add scaler late-line meter read (console 'Y') for display-artifact diagnosis
    Reads VideoFbRead2's meterLate counter over the SPI status link (MISO bytes
    11/12). Used to confirm the supervisor-screen shimmer is NOT a fetch underrun:
    late-lines = 0 in both Atari and supervisor display modes, so the rows are
    fetched correctly and the artifact is a horizontal pixel-level effect (the
    x3.33 non-integer upscale of crisp 1-px text) visible only on dense content.
    [main.c]
2026-07-11 Sim: demonstrate integer vs non-integer scaling (supervisor shimmer root)
    SupervisorScaleSimTb renders 1-px vertical stripes through VideoFbRead2 and
    prints the upscaled run-lengths:
    non-integer 2.5x -> 3,2,3,2,... (uneven stroke widths = the sub-pixel wobble
    that shimmers on hardware)
    integer 4x -> 4,4,4,4,... (even = crisp)
    Confirms that a 320x240 supervisor buffer (320->1280 = x4, 240->720 = x3) removes
    the sub-pixel ambiguity by construction. Basis for the integer-scaled supervisor
    display path.
2026-07-11 Supervisor menu on HDMI: FPGA-native text overlay (TextOverlay720)
    Render the supervisor menu directly on the HDMI output via an FPGA-native
    1280x720 text generator, replacing the console-only path. The RP2040 streams a
    40x15 character grid to the FPGA over a new SPI 'T' command; TextOverlay720
    rasterises the 8x16 font (single-sourced from firmware/supervisor/font8x16.h via
    Font8x16.scala) straight to 720p pixels — no SDRAM, no scaler — muxed into the
    DVI output while supDisplay is set.
    - RpAtariKeyboard: SPI 'T' (0x54) char-grid write (txtWrEn/txtAddr/txtChar,
    auto-incrementing cell pointer).
    - firmware: fpga_text_write ('T' frames), fbtext.c rewritten from SDRAM-pixel
    rasteriser t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
2026-07-12 supervisor: auto-configure FPGA from SD core.rbf at boot (SD-side boot)
    The FPGA was loaded only from the onboard EPCS config-flash at power-on, so a
    stale EPCS bitstream (without the HDMI supervisor overlay) ran on cold boot even
    after the SD core was updated. Make the SD card the source of truth: after
    staging /atari/800/core.rbf to flash, JTAG-configure the FPGA from it at every
    boot, overriding whatever EPCS brought up. Update the core by dropping a new
    .rbf on the SD; it is re-staged only when its size/mtime change (no flash wear
    per boot), and fpga_staged_len() rejects a corrupt image, so a bad/absent core
    just leaves the safe EPCS bitstream running.
    Placement matters: the config call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
2026-07-12 sim: measure CPU bus-cycles/frame vs ANTIC DMA (cycle-stealing baseline)
    Quantifies the missing ANTIC DMA cycle-stealing (project_cpu_cycle_stealing):
    the 6502 keeps cycles a real Atari would hand to ANTIC, so CPU-bound games
    (Defender) run fast. Config matches hardware (internal_ram=49152, BRAM).
    Per frame it derives, from the RELIABLE signals (notifyAntic + refresh + frame
    geometry — the CPU-grant count is inflated by fast-BRAM re-granting so it's not
    used): machine cycles, ANTIC DMA cycles, refresh, our-CPU (loses only refresh)
    vs real-800-CPU (also loses ANTIC), and the speedup.
    Baseline on Star Raiders' display: 35568 machine cyc/frame, 5206 ANTIC DMA,
    ourCPU=32760 vs realCPU=27554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
2026-07-12 Fix CPU turbo: THROTTLE_COUNT_6502 31 -> 0 (real 1.79MHz, cycle-accurate)
    CPU-bound games (Defender) ran ~19x too fast. Root cause is NOT missing ANTIC
    cycle-stealing (that works) — it's turbo. THROTTLE_COUNT_6502=31 means "run the
    6502 as fast as memory allows"; on the old SDRAM design slow memory limited that
    to ~1x, but the ANTIC-jitter fix (RAM in always-ready BRAM, internal_ram=49152)
    removed the limit, so 31 became ~18.8x turbo — which bypasses the arbiter's
    cycle-stealing. Frame-locked games spin on VBI so they look normal; CPU-bound
    Defender was exposed. Setting it to 0 runs the 6502 at real 1.79MHz where the
    memory arbiter correctly hands ANTIC-DMA + refresh cycles away from the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
2026-07-12 docs: update STATUS/README/ARCHITECTURE for this session's work
    - STATUS.md rewritten to current state: SD-side FPGA boot (RP2040 configures the
    FPGA from /atari/800/core.rbf at power-on; EPCS baseline fallback; USB-Blaster
    for dev), on-screen Alt-F12 supervisor menu on HDMI (TextOverlay720, with the
    720p-on-1080p-monitor shimmer caveat), and cycle-accurate 1.79 MHz CPU
    (THROTTLE_COUNT_6502=0). Refreshed commit trail, deploy steps, next steps.
    - README.md: current-focus note + move the RP2040 JTAG loader from "planned" to
    implemented (USB-Blaster emulation + SD-side config).
    - ARCHITECTURE.md: banner marking it as the early SDRAM-based bring-up, pointing
    to STATUS.md; the debuggi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
2026-07-12 ECP5 HDMI bring-up: 640x480 self-contained jitter test (Colorlight i5)
    Self-contained ECP5 HDMI test top so the output path can be validated with zero
    external wiring (no Atari core, RP2040, SD or SDRAM): 25MHz osc -> PLL (125MHz
    TMDS + 25MHz pixel) -> a fixed 640x480 "supervisor-like" text screen -> HDMI. Lets
    us eyeball jitter/shimmer on sharp white text before wiring anything.
    - Ecp5DvidOut: the DvidOut 10:1 DDR serialiser adapted to ECP5 (ODDRX1F via
    ecp5_ddr_out.v instead of Altera ALTDDIO), driving P and N explicitly to match
    the i5's HDMI pins. Reuses the portable TmdsEncoder as-is.
    - Hdmi480pText: 640x480 timing + fixed text (Font8x16, x2) + RGB check strip.
    - pll_hdmi_ecp5.sv: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
    [ecp5_ddr_out.v, pll_hdmi_ecp5.sv]
2026-07-13 docs(i9+): common HDMI diff pairs for a shared ECP5/Artix base board
    Derived the four SODIMM pin pairs that are true differential on BOTH the Artix
    (i9+, XC7A50T-FGG484) and the ECP5 (i5/i9, LFE5U-*F-BG381) modules, so one
    base board can drive proper differential HDMI on either family:
    Lane SODIMM P/N Artix P/N ECP5 P/N (bank 34)
    CLK 69 / 71 AA1 / AB1 U18 / U17 matched
    D0 83 / 79 Y3 / AA3 L18 / M18 matched
    D1 95 / 99 Y6 / AA6 G20 / F20 ECP5 P/N swapped -> invert lane
    D2 109 / 111 AA8 / AB8 E19 / D20 ECP5 P/N swapped -> invert lane
    Method: Vivado DIFF_PAIR_PIN (xc7a50tfgg484-1) x prjtrellis iodb.json (CABGA381,
    PIO A/B & C/D pa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
2026-07-13 firmware: SD direct-wire on the RP2040-STAMP + console-free SWD self-test
    The STAMP is now jumper-wired straight to the SD socket (bypassing the old
    FPGA passthrough); the SPI1 pins (clk=10, copi=11, cipo=12, cs=13) are
    unchanged, but there is no card-detect line in the direct hookup, so
    sd_card_present() was reading a floating/pulled-up GPIO14 and reporting "no
    card" — blocking init. Make it always-present and let sd_init() be the real
    test.
    Add a small SD self-test (g_selftest struct) populated early in main() and
    read over SWD, because the STAMP's native-USB console is unreliable (damaged
    connector) and the RP2040 GPIOs only reach a header via the FPGA (no free UART
    pins) — the debug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
    [main.c, sd_spi.c]
2026-07-13 docs(i9+): final HDMI connector wiring + per-chip inversion, M12L64322A SDRAM
    Peter finalized the base-board HDMI pin assignment from the board layout
    (connector wires straight through, no P/N swap at the connector):
    CLK HDMI-/+ -> SODIMM 69/71
    TX0 HDMI-/+ -> SODIMM 79/83
    TX1 HDMI-/+ -> SODIMM 95/99
    TX2 HDMI-/+ -> SODIMM 109/111
    Record the per-lane TMDS inversion each FPGA build needs. CLK and TX0 are the
    same on both chips (invert / none); TX1 and TX2 differ because those are the
    "swapped" pairs (Artix and ECP5 put True/Comp on opposite SODIMM pins). The
    connector-+ (99/111) is the ECP5's True pin but the Artix's complement pin, so:
    Artix (i9+) build: invert CLK + TX1 + TX2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
2026-07-13 docs(i9+): verify the 8 HDMI SODIMM pins are free carrier I/O
    No schematic needed: the colorlight_i9plus_v6.1.md doc lists both the SODIMM
    edge pinout and every on-module peripheral's FPGA balls (SDRAM/flash/2xPHY/LED/
    clock/JTAG). The 8 HDMI balls (AA1/AB1/Y3/AA3/Y6/AA6/AA8/AB8) appear only in the
    edge table and in none of the peripheral tables, and sit in the opposite package
    corner (bank 34) from the peripherals. Resolves the open "confirm not tied to
    on-module peripherals" caveat; notes an optional JTAG boundary-scan check for
    hardware-definitive confirmation once the board exists.
2026-07-13 gitignore: ignore Vivado journal/log/backup artifacts repo-wide
    Vivado can be run from any directory (e.g. root, for pin analysis), leaving
    vivado.jou/log + vivado_<pid>.backup.* behind. The existing rules only covered
    boards/i9plus-6v1/, so root-level runs left untracked clutter. Make the patterns
    repo-wide and add .Xil/.
2026-07-13 docs(i9+): add base-board netlist review notes
    Record the review of the exported base-board netlist: HDMI TMDS->SODIMM verified
    matching the pin map; the RP2040 pin map on this board (SD on SPI0/GPIO20-23 +CD
    GPIO19, FPGA link GPIO10-18, JTAG->J5, USB, POT->ADC) and the firmware re-pin it
    implies; decisions taken (ESD moved to connector side, HDMI +5V ferrite +150mA
    polyfuse, joystick pin7 stays 3V3 so paddle POTs stay ratiometric with no ADC
    divider); and open items (FPGA config path only reaches J5 not the FPGA, declare
    TMDS diff pairs in the PCB tool, DDC/HPD not routed to FPGA, 3V3 reg budget).
2026-07-13 docs(i9+): resolve FPGA config path + record module JTAG header locations
    JTAG can't run over the SODIMM (TDO/TMS/TCK on pins 68/76/94 but TDI/ball J3 is
    not brought out), so the base board's J5 header -> the module's own JTAG header is
    required and correct; the RP2040 SD-side FPGA load still works through it. The
    module JTAG header sits in a different place per family, so fixed pogos are
    per-module (J5 + flying lead is portable):
    Artix i9+ : right-edge 1x4 pads J2=TDO J3=TDI J4=TMS J5=TCK
    ECP5 i9/i5 : top-left 1x4 pads J30=TDO J32=TDI J31=TMS J27=TCK
    Moves the FPGA-config item out of "open" into a resolved JTAG subsection.
2026-07-13 docs(i9+): JTAG via soldered flying lead from J5 (not pogo)
    Pogo pins need sub-mm placement with no Colorlight mechanical drawing and would
    be per-module (Artix vs ECP5 headers are in different spots). A soldered flying
    lead from J5 (GND + TMS/TCK/TDI/TDO, 5-wire) to a mating connector at the module
    JTAG header avoids the alignment problem and is portable to either module; JTAG
    is slow so a short lead is fine. Module-end pad order differs per family, so use
    a per-module adapter or labelled leads.
2026-07-14 docs(i9+): add measured JTAG pad coords + board-placement formula
    Record the calipered Artix i9+ module JTAG pad locations (top side, from the
    bottom-left corner): J2/TDO 63.84,8.18 then J3/J4/J5 stepping +2.54mm in +Y, at
    2.54mm (0.1") pitch. Add the translation to board coordinates from an arbitrary
    connector location:
    pad X = Cx + 30.04 (Cx = connector centerline)
    pad Y = Cy + 8.18 + 2.54*n (Cy = card-slot seating line; n=0..3 -> J2..J5)
    with the component-down / flipped-orientation / -Y / slot-line adjustments, a
    worked example (Cx=-11.8, Cy=-4.8 -> X=18.24, Y=3.38/5.92/8.46/11.00), and the
    J2/J3 connector-body collision note. ECP5 module JTAG is elsewhere (top-left).
    Co-Authored-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
2026-07-14 docs(i9+): define the JTAG-formula reference point (Cx,Cy) precisely
    Clarify that Cx/Cy are not the footprint's arbitrary origin but a specific
    point: the midpoint of the seated module's gold-finger edge -- Cx = slot
    centerline (midpoint of the 200-contact array), Cy = card-seating line (card-edge
    stop from the connector datasheet). Set the footprint origin there so its placed
    coordinate is (Cx,Cy), else add the offset. Resolves the mismatch where the
    footprint's own center is not at that point.
2026-07-14 docs(i9+): pin the JTAG-formula reference to the TE 1473006 connector
    The formula's (Cx,Cy) datum on this board's socket (TE 1473006, 0.6mm-pitch
    200-pos DDR2): Cx = CONNECTOR CENTER LINE (center of symmetry) -- explicitly NOT
    the MECHANICAL KEY CENTER LINE, which the datasheet offsets by 3.1mm and is a
    likely source of a placement mismatch; Cy = card-seating line ~ midway between
    the two solder-pad rows (or the sheet-1 recommended mating-PCB-outline edge),
    good to ~1mm which is plenty for the flying-lead placement.
2026-07-14 docs: i5 README with JTAG mapping + fix i9+ JTAG orientation
    i9+ README: the module can seat only two ways in the horizontal connector, and
    180deg is an in-plane point-reflection through (Cx,Cy) that flips X AND Y
    together -- the earlier "independent X/Y flip" wording was wrong. Present
    orientation A vs B explicitly and set the worked example to orientation B (this
    board): J2..J5 at X=-41.84, Y=-8.88/-11.42/-13.96/-16.50.
    New boards/i5-7v0/README.md: ECP5 i5 (LFE5U-25F) notes -- HDMI bring-up test
    pointer + the module JTAG header (top-left 1x4 row J30/J32/J31/J27 =
    TDO/TDI/TMS/TCK, 2.54mm, J30 at module 9.52,33.55). Board coords via the same
    orientation-B transform: J30..J27 at Y=-34.25, X=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
2026-07-14 docs(i5): expand README with build + HDMI test details
    Full ECP5 flow (yosys/nextpnr-ecp5/ecppack, --25k CABGA381 speed 6): the
    build_hdmi_test.sh 4-step 640x480 HDMI test (sbt-generate -> synth -> pnr ->
    pack), PLL clocks (25 -> 125MHz TMDS + 25MHz pixel), the LVCMOS33 pseudo-diff
    HDMI pinout (G19/H20 E20/F19 C20/D19 J19/K19, clk P3), resource use (~1382 LUT /
    6%, 4 ODDRX1F, 1 EHXPLLL), openFPGALoader programming, and the Makefile Atari-
    core fit-check (4909 LUT 20%, 34/56 DP16KD 60% -> full core fits the 25F).
2026-07-15 board defs + CLI switches for supervisor + FPGA (Colorlight base board)
    Supervisor firmware: `cmake -DBOARD=colorlight|qmtech` selects the RP2040 pin map
    via a BOARD_<UPPER> compile define. Colorlight pinout: SD on SPI0/GPIO4-8 (+card-
    detect), FPGA link on SPI1/GPIO10-13, JTAG bit-bang GPIO22-25, USB host GPIO0-3.
    Guarded in sd_spi.c/main.c/blaster.c/jtag.c behind #ifdef BOARD_COLORLIGHT with
    the legacy pinout in #else. Both targets build clean.
    FPGA board defs (boards/atari-800-rp2040-colorlight/fpga/), generated from the
    netlist: pinmap.csv (SODIMM<->net<->ECP5 ball<->Artix ball, 69 signal pins),
    i5.lpf (ECP5/nextpnr), i9plus.xdc (Artix/Vivado), and fit/ pin-validity check.
    Verified: nex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
    [pinmap.csv]
2026-07-15 fpga(hdmi): record verified 1080p verdict on the i9+ (XC7A50T-2)
    Vivado place+route of a real OSERDESE2 10:1 serializer (oserdes10.v) on the board
    HDMI pin (Y3/AA3), MMCM 25->148.75/743.75, xc7a50tfgg484-2: setup/hold met, I/O
    data rate OK (no HR-bank violation), places+routes clean with the MMCM floorplanned
    into the HDMI clock region X1Y0 -- but the OSERDESE2/CLK min period is 1.471ns
    (~680 MHz max) on the -2 grade, so standard 1080p60 (742.5 MHz serial) misses by
    ~9%. The i9+ -2 thus caps ~720p/1600x900, same class as the ECP5 i5 -> no 1080p
    edge, so the i5 becomes primary. Saves oserdes10.v (works for 720p) + HDMI-TIMING.md
    and corrects the i9+ README's wrong "native 1080p60 comfortably"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
    [oserdes10.v]
2026-07-15 docs(hdmi): status write-up - ECP5 ODDRX1F caps 234MHz, 720p needs ODDRX2F
    Verified the current Ecp5DvidOut (ODDRX1F+5:1 fabric gearbox) tops out at 234MHz
    via nextpnr (FAIL at 370), so it covers 640x480 (proven) to ~800x600 but not 720p
    (371MHz). 720p needs an ODDRX2F/ECLK rebuild (in progress). Status table: neither
    chip does 1080p; both cap ~720p; i5 is primary; 640x480 works today.
2026-07-15 fpga(hdmi): ECP5 720p ODDRX2F feasibility PROVEN on i5-ext pins
    nextpnr-ecp5 (25k/CABGA381/speed6): PLL(25->370)->ECLKSYNCB->ECLK(370)->CLKDIVF/2
    ->SCLK(185), 8x ODDRX2F driving all 4 i5-ext HDMI lanes (G19/H20 E20/F19 C20/D19
    J19/K19). All 8 pins promoted to bank 2 ECLK0 (one shared edge clock), placed 21
    cells 0 errors -> the i5-ext HDMI pins are ECLK-capable and HW-testable on the
    existing board. SCLK fabric 387MHz max (2x margin), ECLK370 on dedicated path.
    So 720p on the ECP5 is feasible; remaining work is the gearbox integration (feed
    ODDRX2F's 4 bits/SCLK). Saves the proven clocking pattern + README.
    [oddrx2f_clocking_test.v, pll371.sv]
2026-07-15 fpga(hdmi): ODDRX2F 10:1 TMDS gearbox + SpinalSim (verified)
    The sim-verifiable core of the ECP5 720p serializer: packs 2 pixels (20 bits) into
    5 ODDRX2F nibbles, word[c*4 +: 4] -> D0..D3, serialising LSB-first (TMDS order).
    SpinalSim TmdsGearboxX2SimTb drives 300 random 2-pixel words and checks the 5
    emitted nibbles reconstruct each word LSB-first: PASS. Next: pixel->SCLK word
    assembly/alignment + the ECLKSYNCB/CLKDIVF/ODDRX2F primitive wrapper + a 720p top.
2026-07-15 fpga(hdmi): Ecp5DvidOutX2 720p serializer front-end + end-to-end SpinalSim
    Full ECP5 720p serializer datapath: pixel-domain TMDS encode + 2-pixel/20-bit word
    assembly, crossed to the SCLK domain (synchronised load pulse + stable-word sample,
    tagged crossClockDomain) and geared to 4-bit ODDRX2F nibbles. Clocks are inputs so
    the whole path is simulatable. Ecp5DvidOutX2SimTb runs two async clocks at 2.5:1 and
    checks the TMDS clock lane serialises to a clean periodic, DC-balanced 1111100000:
    PASS (at a fixed rotation = the alignment offset, a hardware phase/bitslip item).
    Next: ECLKSYNCB/CLKDIVF/ODDRX2F wrapper + 720p top + nextpnr timing.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
2026-07-15 fpga(hdmi): full ECP5 720p ODDRX2F serializer builds + meets timing
    Integrated 720p serializer through nextpnr on the i5-ext HDMI pins (LFE5U-25F-6):
    ecp5_clkgen720 (PLL 25->370/74 + ECLKSYNCB->ECLK + CLKDIVF->SCLK) -> Ecp5DvidOutX2
    -> ecp5_oddrx2x4 (4x ODDRX2F) -> gpdi P/N. Reworked the gearbox from a dynamic 5:1
    mux to a 20-bit shift register (functionally identical, re-simmed PASS) which lifted
    the SCLK domain from 156 -> 218 MHz. Result: SCLK 218MHz (need 185) PASS, pixel 77MHz
    (need 74, reused 640x480 gen) PASS, ECLK370 on the dedicated edge-clock path. The
    720p serializer is proven end to end; remaining = 720p video timing gen, bit-slip
    alignment (fixed rotation, hardware), and Atari v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
    [ecp5_clkgen720.v, ecp5_oddrx2x4.v, pll_hdmi_ecp5.sv]
2026-07-15 fpga(hdmi): 1280x720p60 timing generator + colour-bar test pattern
    Hdmi720Bars: CEA-861 720p timing (1650x750, positive HSync/VSync, ~74 MHz pixel)
    with a diagnostic pattern -- 1px white border, 8 vertical colour bars (exercises all
    3 TMDS lanes), and a white box moving 1px/frame (confirms live refresh). Swapped into
    Atari800Ecp5Hdmi720TestTop in place of the reused 640x480 gen. Full 720p design now
    closes with margin: pixel 135MHz (need 74), SCLK 224MHz (need 185), 311 LUTs (1%).
    A flashable h720.bit is produced by the i5 build; ready to test on the i5-ext board.
2026-07-16 fpga(hdmi): 720p test - true 8 colour bars (was 10 via >>7)
    ECP5 720p ODDRX2F serializer HARDWARE-VERIFIED on the i5-ext board: clean colour
    bars in correct order + moving box, TMDS locked, bit alignment correct.
2026-07-16 docs(hdmi): ECP5 720p HARDWARE-VERIFIED on i5-ext board
2026-07-16 fpga(hdmi): true-differential LVCMOS33D output - clean 720p, HW-verified
    The pseudo-diff output (two separate ODDRX2F for P and N) skews at 742 Mb/s (fine at
    480p, not at 720p) and caused transition-induced interference at sharp edges (visible
    as trailing noise off the white box over cyan/green). Switch to a single ODDRX2F per
    lane driving a matched P/N pair via LVCMOS33D (the i5-ext HDMI pins ARE valid ECP5 diff
    pairs). Result on hardware: solid, clean colour bars, no interference. Simpler too (4
    driven pins, not 8). Top now outputs P-only `gpdi`; hdmi720_lvds.lpf declares the 4 P
    pins LVCMOS33D; build_720.sh uses it.
2026-07-16 fpga(hdmi): Hdmi720Scaler - genlocked 3x BRAM upscaler (Atari->720p) [WIP]
    Step 1 of Atari-video-at-720p: a BRAM-only (no SDRAM) genlocked scaler. Taps the
    Atari NATIVE video (~336x240) and scales 3x integer -> 240 lines x3 = 720 exactly,
    336 px x3 = 1008 centred in 1280. Dual-clock circular multi-line buffer bridges the
    Atari sys clock to the 720p pixel clock; read side reads each line/pixel 3x, genlocked
    to input VSYNC. Compiles; not yet sim-verified or integrated/tuned on hardware. Next:
    sim the scaler, then a top wiring Atari core + GtiaPalette -> scaler -> Ecp5DvidOutX2,
    with the Atari & 720p clocks genlocked from one PLL.
2026-07-16 Atari 800 -> 720p HDMI integrated top (i5): genlocked 3x scaler, timing-clean
    Fold the Atari core into the 720p ODDRX2F HDMI path:
    - Atari800Ecp5Hdmi720Top: Atari core (48K BRAM, 800 OS, Star Raiders) -> GtiaPalette
    -> Hdmi720Scaler -> Ecp5DvidOutX2 (LVCMOS33D). Two PLLs: PllAtari800 (25->37.5) +
    ecp5_clkgen720 (25->370/74), scaler genlocks the 720p raster to the Atari VSYNC.
    - Hdmi720Scaler: replace the /3 combinational dividers on the 74 MHz pixel path
    (dropped Fmax to 32/67 MHz) with incremental phase counters, and add one uniform
    output pipeline stage to break the BRAM-read -> TMDS-encoder path. cg_pixel 32 -> 122 MHz.
    - pll_ecp5.sv: correct PllAtari800 to ecppll params (CLKI_DIV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
    [pll_ecp5.sv]
2026-07-17 Atari 800 -> 720p HDMI booting on i5 (Star Raiders, colour, centred)
    Get the integrated top actually running on hardware. Root causes found (sim booted
    but hardware was black, then blue, then off-centre/jittery):
    - Reset: raw async release of pllA.locked let core regs leave reset on different edges
    (reset-tree skew) -> boot corruption on hardware (fine in sim). Now async-assert /
    sync-release (2-FF), matching the verified Atari800Rp2040HdmiLgTop.
    - SDRAM stub: hangs the CPU on the first SDRAM access; loop SDRAM_REQUEST_COMPLETE
    back to SDRAM_REQUEST so accesses complete (RAM/ROM are all in BRAM).
    - Colour: VIDEO_B is the GTIA colour INDEX (VIDEO_R/G/B ~0 at palette=0) -> resolve via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
    [pll_ecp5.sv]
2026-07-17 Atari 720p: single shared PLL + vTotal>Atari-frame (genlock cleanup)
    - One PLL: add a 3rd VCO output (740/20=37 MHz) for the Atari sys clock so sys:pixel is
    exactly 1:2 and phase-locked (no inter-PLL jitter). Drop the separate PllAtari800.
    - vBack 20->50 (vTotal 780) > the Atari frame (627228 sys = 1.254M pixel clks = ~760 of our
    lines, measured in Atari800Ecp5BootSimTb) so the VSYNC genlock reset lands in vertical
    blanking, not after a natural raster wrap. Output frame now deterministic each frame.
    Residual edge flicker remains (line-buffer read/write coherency at the nearest-neighbour
    3x scale); the SDRAM framebuffer is the clean fix.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
    [ecp5_clkgen720.v, pll_hdmi_ecp5.sv]
2026-07-17 Atari 720p: exact-frame timing kills wobble; vLag fixes read-during-write; centred
    - hTotal=1596/vTotal=786 so the Atari frame (1,254,456 pixel clks) = exactly 786 output lines
    AND 1 Atari line = exactly 3 output lines. Genlock reset lands identically every frame ->
    the vertical wobble is gone.
    - That exact 1:3 lock made the reader read each line as the writer wrote it (dual-port
    read-during-write = the 'split' character). Add Hdmi720Scaler vLag: reset vc into blanking so
    the reader reaches the top vScale*vLag rows later -> writer keeps a vLag-line head start and
    the reader always reads a completed line. vLag=4 (< nLines=16).
    - Star Raiders title is the Atari WIDE playfield (384 hi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
2026-07-17 supervisor: add second PIO-USB host root port (both USB-A connectors live)
    After tuh_init(1) (root port 0 = primary per USE_USB2), add the OTHER connector as a second
    root port via pio_usb_host_add_port(). It reuses the shared tx/rx state machines (no extra PIO
    SM -> no clash with the JTAG blaster) and the host loop already polls all PIO_USB_ROOT_PORT_CNT
    ports. pinout per connector (DMDP = D+ on the higher GPIO, DPDM = normal).
    Hardware-verified on the qmtech-rp2040-stamp board: keyboard on the top connector (USB1 gp7/6)
    AND a joystick on the bottom (USB2 gp8/9) enumerate simultaneously (2 HID devices, reports flow).
    NOTE: build for the correct board -- cmake -DBOARD=qmtech (USB gp6-9) vs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
    [main.c]
2026-07-17 rm2_test: standalone RM2 (CYW43439) bring-up tools (init + WiFi connectivity)
    Two standalone pico-sdk firmwares (no USB/blaster -> no PIO contention), reading results out of
    RAM globals over the debug probe (no console needed):
    - rm2_test: cyw43_arch_init() only. HARDWARE-VERIFIED alive: init==0, test reg 0xFEEDBEAD read
    back over half-duplex gSPI on the stamp-direct pins (CLK25/DATA24/CS23/ON22 via CYW43_DEFAULT_PIN_WL_* overrides).
    - wifi_test: lwip arch -> associate + DHCP + ICMP ping gw/8.8.8.8.
    Finding: WiFi bring-up FAILS at cyw43_ensure_up -> cyw43_ll_bus_init -6 (SDPCM ioctl-id mismatch,
    control channel desync) REGARDLESS of gSPI clock (CYW43_PIO_CLOCK_DIV_INT 2/8/16 all identica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
    [lwipopts.h, main.c, wifi_test.c]
2026-07-17 turbo mode: runtime 6502 speed toggle from the supervisor menu
    FPGA (qmtech core = Atari800Rp2040HdmiLgTop):
    - RpAtariKeyboard: 'C' control frame now carries 7 bits; bit 6 = ctrlTurbo output.
    - LG top: THROTTLE_COUNT_6502 := Mux(kbd.ctrlTurbo, 31, 0) -- runtime turbo vs real 1.79 MHz
    (was hard-fixed at 0; the comment already anticipated a runtime config reg).
    Supervisor firmware:
    - persistent g_turbo flag; '[t] turbo: off/ON' line in the on-screen + console menu; 't' key
    toggles it. The turbo bit (0x40) is OR'd into the pause (0x30) and resume (0x00) 'C' frames
    so it holds across pause/resume. Old cores ignore bit 6 (harmless).
    Built: SV regen clean, Quartus 0 errors -> core.rbf (7185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
    [supervisor.c]
2026-07-17 docs: record the runtime turbo toggle (STATUS.md + board ARCHITECTURE.md)
    - STATUS.md: TL;DR, CPU-timing, supervisor-menu, and control-protocol sections now
    describe the '[t]' turbo toggle (THROTTLE_COUNT_6502 := Mux(ctrlTurbo, 31, 0),
    control-frame bit 6, live 0<->31, defaults off on reset, game-logic-speed only).
    Refreshed the commit trail (BRAM migration + config boot + turbo) and the date.
    - ARCHITECTURE.md: added bits 5/6 (supDisplay, turbo) to the 'C' control row.
2026-07-19 Add Artix-7 XC7A100T + RP2040 board: HDMI pinout, netlist, docs
    New board boards/atari-800-rp2040-qmtech-xc7a100t/ — the Artix path to native
    1080p60 (crisp supervisor text), reliable RM2 wireless on a real PCB, and an
    optional FPGA crypto coprocessor.
    - ARCHITECTURE.md: board target (xc7a100tfgg676, DDR3, RP2040-STAMP supervisor),
    rationale, and phased roadmap.
    - pin-mapping.md: HDMI on U4 bank 35 (B5/A5 clk + B4/A4, A3/A2, D4/C4 data),
    TMDS_33 recipe, length-match/impedance findings; bank-35 supply is powered by
    default via core-board R14/R15 (0 ohm) -> internal 3V3 (VCCO header pins NC is
    fine); full RP2040-STAMP GPIO map, RM2/SD direct on RP2040, and debug section
    (U6 = SWCL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
2026-07-19 xc7a100t docs: RM2 dedicated 3.3V buck + J10 JTAG VREF note
    - pin-mapping.md: RM2 can be fed from its own optional DSN-MINI-360 3.3V buck (or
    the core-board 3V3), so the WiFi-on peak need not load the core-board regulator.
    - Clarify J10 -> core-board 6-pin JTAG header: the VCC/VREF pin is intentionally
    omitted (RP2040 bit-bangs JTAG at 3.3V, FPGA JTAG bank is 3.3V -> no VREF needed);
    4 JTAG signals + GND are complete.
2026-07-19 gitignore: cover ECP5 build dirs, Quartus stragglers, and build logs
    - boards/**/build/ (any board's nextpnr/ECP5 build dir; replaces the two
    per-board lines) — was leaving boards/i5-7v0/oddrx2f_720/build/ untracked.
    - boards/**/*.map, *.cof, *.jic — Quartus JIC/programming-flow stragglers left
    outside output_files/.
    - boards/**/*.log and firmware/**/*.log — build/tool logs (quartus_build.log,
    rm2_test build/cmake logs).
    - timestamped screen-capture *.jpg (matching the existing *.png/*.mp4 rules).
2026-07-19 xc7a100t: dedicated DSN-MINI-360 buck (U5) for RM2 3.3V
    Updated baseboard netlist: adds buck U5 (VIN->RM_3V3) and moves RM2 (U4) power
    onto that dedicated RM_3V3 rail instead of the shared core-board 3V3, so the
    RM2 WiFi-on peak (~250-400 mA) no longer loads the core-board regulator. RM2 +
    its buck are optional. Re-reviewed: HDMI pins unchanged, no dangling nets.
2026-07-19 Add QMTech Wukong XC7A100T board notes (MiST/MiSTer experiment bench)
    boards/qm_xc7a100t_wukong/ — README.md + pin-mapping.md for the off-the-shelf
    Wukong V3 dev board. Chosen as the experiment-first platform for MiST/MiSTer
    core ports because it carries BOTH memory types on one board (the MiSTer split):
    - W9825G6KH-6 SDR SDRAM (same chip as the 10CL025 -> reuse SdramStatemachine)
    for latency-critical core main RAM;
    - MT41K128M16 DDR3L (256 MB, via MIG) for framebuffer/scaler/bulk.
    Plus on-board HDMI (TMDS_33 bank 35: D4/C4, E1/D1, F2/E2, G2/G1), GbE, CH340N
    USB-UART. Pinouts from QMTech's Vivado reference designs (Test01/04/05/06/08/10).
    Self-contained -> cores can be brought up standal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
2026-07-19 wukong notes: Pico/Pico W JTAG programming + supervisor plan
    Add a Programming & supervisor section: the Wukong is Xilinx so the Altera
    USB-Blaster loader doesn't apply, but two local tools cover it —
    - ~/pico-dirtyJtag (Pico USB JTAG cable + openFPGALoader) for bench programming;
    - ~/pico-pio-uart-jtag, whose jtag/fpga_xilinx.c already does on-device Xilinx
    7-series config (JPROGRAM/CFG_IN/JSTART + .bit parsing), as the autonomous
    supervisor base — feed the .bit from SD/FatFs.
    Prefer a Pico W (onboard CYW43439 = RM2 wireless on a real PCB); note reserved
    GPIO23/24/25/29. USB-keyboard host + FatFs/menu/SIO carry over.
2026-07-20 wukong notes: Pico 2 W supervisor + debug-probe SWD wiring (verified)
    Supervisor target is a Pico 2 W (RP2350; pico-pio-uart-jtag supports it, extra
    PIO eases CYW43+USB+JTAG). Document flashing via the RP debug probe over SWD
    (SWCLK/GND/SWDIO, probe 'D' port not 'U'), the rp2350.cfg location, and the
    'cannot read IDR' = reversed-wire symptom. Verified: after swapping a reversed
    SWCLK/SWDIO, DPIDR 0x4c013477, dual Cortex-M33 examined OK.
2026-07-20 wukong notes: dirtyJtag on Pico 2 W verified (reads XC7A100T); pico-pio-uart-jtag RP2350 hang
    Bench programming confirmed working: pico-dirtyJtag built for pico2_w on a Pico 2 W,
    JTAG on GP0-3 (TCK/TDO/TMS/TDI) -> Wukong header, openFPGALoader --cable dirtyJtag
    --detect reads idcode 0x3631093 = Artix-7 XC7A100T. pico-pio-uart-jtag hangs on
    RP2350 (core1 multicore launch stalls before USB) -> deferred for the supervisor.
2026-07-20 wukong notes: SPI flash not used — supervisor JTAG-configs from SD every boot
2026-07-20 Wukong Phase 0: SpinalHDL 1080p60 HDMI colour bars (hardware-verified)
    New parallel board boards/atari-800-wukong-1080/ (does not touch existing builds):
    proves SpinalHDL -> Vivado -> rgb2dvi/OSERDESE2 -> native 1080p60 on the QMTech
    Wukong XC7A100T, programmed via the Pico 2 W dirtyJtag link.
    - Atari800Wukong1080Top.scala: SpinalHDL 1080p60 timing + colour-bar generator;
    MMCM + rgb2dvi blackboxes (PllHdmi/DviEncoder idiom). vid_pData reordered {R,B,G}
    to match this board's TMDS channel mapping.
    - vendor: wukong_hdmi_mmcm.v (MMCME2 50->148.4 MHz), rgb2dvi_wrapper.vhd + Digilent
    rgb2dvi VHDL (TMDS_Encoder.vhd patched: unconstrained function return for strict
    VHDL-2008/Vivado 2025.2).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
2026-07-20 Wukong Phase 1: Atari 800 at native 1080p60 (hardware-verified, Star Raiders)
    Standalone Atari-on-Artix at 1080p on the QMTech Wukong, booting from baked BRAM
    (internal_rom=3: 800 OS + Star Raiders cart; 40 KB RAM in BRAM). Reuses the LG
    pipeline unchanged (Atari800CoreSimpleSdram, SdramStatemachine on the on-board
    W9825, SdramArbiter3, VideoFbWrite, VideoFbRead2 re-parameterized to 1920x1080,
    GtiaPalette) -> Phase 0's rgb2dvi skeleton. Xilinx layer = wukong_atari_mmcm
    (sys 56.25 + SDRAM 112.5, phase-locked) + the pixel MMCM; vid_pData {R,B,G} and
    sync inverted for this board's rgb2dvi.
    Verified: Star Raiders boots and displays stable at 1080p, programmed via the
    Pico 2 W dirtyJtag link.
    K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
    [wukong_atari.xdc, wukong_atari_mmcm.v]
2026-07-20 wukong: record Pico 2 W supervisor wiring + Phase 2 plan
    Pico 2 W (RP2350) supervisor pinout: JTAG GP0-3, USB kbd D-=4/D+=5, FPGA SPI1
    link GP12-15 -> J11 (D5/G5/G7/G8), SD SPI0 GP16-19, CYW43 GP23/24/25/29.
    Supervisor is single-core (safe on RP2350); Phase 2 = BOARD_WUKONG pin map +
    pico2_w build + graft Xilinx fpga_xilinx.c for SD FPGA-config + re-add
    RpAtariKeyboard/internal_rom=5 in the HDL.
2026-07-20 Wukong Phase 2a: USB keyboard via Pico 2 W supervisor (hardware-verified)
    Keyboard-controlled Atari at 1080p on the Pico 2 W (RP2350). Chain verified:
    USB HID host (GP4/5) -> supervisor -> SPI1 link (GP12-15 -> J11 H4/F4/A4/A5) ->
    FPGA RpAtariKeyboard -> Atari (F5 starts Star Raiders).
    HDL (Atari800WukongTop): add RpAtariKeyboard on the fpga_spi_* link, feed
    KEYBOARD_RESPONSE + console keys, HALT |= ctrlHalt; XDC SPI pins on J11 bank 35.
    Firmware: BOARD_WUKONG pin map (SPI1 GP12-15, USB D+=5/D-=4), pico2_w build,
    guard SD-stage/FPGA-config/do_boot/2nd-USB-port (baked ROM, dirtyJtag-programmed);
    BOARD_WUKONG JTAG pins TCK=0/TDO=1/TMS=2/TDI=3 in jtag.c + blaster.c so
    'openFPGALoader --cable u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
2026-07-20 Wukong: native 1080p on-screen supervisor menu (Alt-F12)
    Port the FPGA-native text overlay to the Wukong's native 1080p60 path.
    New TextOverlay1080 renders the supervisor's existing 40x15 char grid + 8x16
    font directly at 1920x1080 (no SDRAM, no upscaler) — so NO firmware change:
    40 cols x 48px (scale x6) = 1920 exact; 15 rows x 64px (scale x4) = 960,
    centred in 1080 with 60px black bars. charH=64 is a power of two so the
    vertical char/font address is a bit-slice; charW=48 uses a column counter.
    CEA-861 1080p60 timing matches VideoFbRead2 so the monitor stays locked.
    Atari800WukongTop: feed textOv from kbd.io.txt*; pause fbWrite while
    supDisplay is set; pixelArea muxes the Atari scaler vs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
2026-07-20 Wukong supervisor: SD on SPI0, and make menu [b] boot safe
    sd_spi.c: add a BOARD_WUKONG case — SD on its own peripheral SPI0
    (GP16=RX/17=CS/18=SCK/19=TX) so it never contends with the FPGA control
    link on SPI1 (GP12-15). The generic #else default wrongly put SD on SPI1
    10-13. Hardware-verified over the console: 'i' -> SDHC/XC 30436 MB, 'd' ->
    mounts and lists / (atari/, config.json).
    supervisor.c: guard sup_boot() for BOARD_WUKONG — this build bakes OS+cart
    (internal_rom=3) with the SDRAM loader tied off (ldComplete:=False), so
    boot_run() would wait forever and hang the whole supervisor (USB stops
    being pumped). Now [b] prints a note and stays in the menu; [q]/Alt-F12
    resumes (SD-indepe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
    [sd_spi.c, supervisor.c]
2026-07-20 Wukong Phase 2c: SD config-boot + SIO disk emulation
    Switch the Wukong Atari to a fully non-proprietary bitstream: internal_rom=5
    (blank loadable BRAM, 48 KB RAM, no baked OS/cart), and let the Pico 2 W
    supervisor stream the 800 OS + cart from the SD card into BRAM and serve
    disk images to the SIO drive emulator.
    Atari800WukongTop (ported from the LG top):
    - internal_rom=5, cartridge_rom="" (nothing proprietary baked in).
    - Core LOAD port (OS ROM / RAM / cart -> BRAM) + SDRAM port-D loader, driven
    by RpAtariKeyboard's loader signals; ldComplete mux.
    - SioBridge: SIO command bus <-> supervisor over the SPI link (disk images
    mounted on SD).
    - Cart-select in a BOOT-reset cfgArea so it surv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
    [main.c, supervisor.c]
2026-07-20 supervisor: gitignore build_* dirs (build_wukong)
    The per-board CMake build dir build_wukong/ wasn't covered by the build/
    pattern.
2026-07-20 RpAtariKeyboard: F8 -> Atari SYSTEM RESET
    F5/F6/F7 already mapped to Start/Select/Option; F8 (HID 0x41) was unmapped.
    Map it to a frame-committed resetKey OR'd into io.ctrlReset (alongside the
    supervisor's 'C' bit-0 reset), so F8 completes the console-key set. On the
    Wukong ctrlReset drives the stretched sys-domain reset -> warm SYSTEM RESET
    (RAM preserved). Benefits the LG board too (shared component).
    Hardware-verified on the Wukong: F8 resets the running machine.
2026-07-20 Wukong Phase 2b: autonomous FPGA config from SD (.bit over JTAG)
    The supervisor now configures the Artix-7 from a .bit on the SD card at
    power-on, before config-boot — so a cold boot brings up the whole appliance
    (FPGA + OS + cart + disks) from the card with no host JTAG.
    fpga_config.c: add fpga_config_from_sd() for Xilinx 7-series. Streams the
    .bit straight from SD (the Wukong's SD is local to the Pico, and the ~3.8 MB
    bitstream won't fit the 1 MB flash-stage region), parses the .bit header to
    find the config data, bit-reverses each byte (Xilinx MSB-first vs the
    LSB-first blaster shift == openFPGALoader's reverse=true for MEM_MODE), and
    runs JPROGRAM/CFG_IN/JSTART via the same blaster-by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
    [config.c, fpga_config.c, fpga_config.h, main.c]
2026-07-20 Wukong: push files to SD over USB ('U') + make push-core
    Deterministic SD file update that bypasses the MSC drive (and its host
    write-back cache / eject footgun that silently left core.bit 0 bytes). The
    firmware 'U' command receives "<path>\n<length>\n<raw bytes>" on the CDC and
    streams it straight to SD via FatFs, self-throttled by USB flow control.
    - main.c: cdc_read_line() + cmd_push_file() ('U'); also a 'T' SD write
    self-test (proves sd_write_block end to end).
    - tools/push_file.py: host side, auto-finds the supervisor CDC, shows progress.
    - board Makefile: `make push-core` streams the built .bit to /atari/800/core.bit;
    `make deploy-core` = build-atari + push-core.
    Verified: make p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
2026-07-20 Wukong: make 'atari' a full over-USB deploy (push core + activate)
    'make atari' now builds the bitstream, pushes it to the SD as
    /atari/800/core.bit, then tells the supervisor to configure the Artix from
    it and boot the Atari — the whole deploy over USB, no JTAG cable.
    push_file.py gains --activate (send 'F' then 'B' after the push). Direct
    SRAM programming over a cable stays available as 'program-atari'; push-core
    / deploy-core still push without activating.
    Verified: push (~23s) -> config done (3825788 bytes) -> boot stream ok.
2026-07-20 Docs: Wukong 1080p appliance — board README, STATUS, Makefile help
    - New boards/atari-800-wukong-1080/README.md: the native-1080p Atari appliance
    — phases 0-2c, architecture (BRAM Atari + SDRAM framebuffer, video pipeline,
    supervisor SPI link, config-boot, autonomous FPGA config from SD), the
    make atari / push-core deploy flow, and the supervisor console commands.
    - STATUS.md: now covers both boards; add a Wukong summary section, date 07-20.
    - Makefile: header + .PHONY updated for the atari/push-core/deploy-core targets.
    - qm_xc7a100t_wukong/README.md: status pointer to the finished appliance.
2026-07-20 i9+ (XC7A50T): 1080p60 HDMI IS achievable on a -2 (corrected)
    Empirical place+route of the Wukong's rgb2dvi OSERDESE2 serializer on the
    i9+ bank-34 HDMI pins at 1080p60 (742.5 MHz serial), both speed grades:
    -1: serial-clock min-period slack -0.808 ns (marginal, ~60% over BUFG spec)
    -2: serial-clock min-period slack -0.246 ns == Wukong 100T-2 (-0.245),
    which runs 1080p60 in hardware.
    The only failing check is the BUFG's *conservative* min-period on the serial
    clock -- not the OSERDES, not the SODIMM pins. The -2 i9+ has the same margin
    as the proven Wukong, so a -2 does 1080p60. The prior "caps at 720p, needs a
    -3" note mistook that conservative flag for a hard wall; corrected i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
    [hdmi_test_top.sv, i9plus_hdmi.xdc]
2026-07-20 Supervisor: on-demand WiFi (Pico 2 W) — Step 1 of the HTTP SD manager
    cyw43_arch (lwIP poll mode) added, off until toggled. Credentials from
    /wifi.txt on the SD (line1 SSID, line2 password). Console 'N' and the
    supervisor menu '[w]' toggle it and show the IP; wifi_poll() pumps
    cyw43+lwIP in the main loop. Only built for _w boards (HAVE_WIFI).
    Hardware-verified on the Pico 2 W (Wukong supervisor): joins "ext-2.4G",
    DHCP IP, responds to ping -- cyw43+lwIP coexist with the PIO-USB host and
    the JTAG blaster on the single RP2350 core, and SD/base are unaffected.
    lwipopts.h already enables the httpd options for Step 2 (the web UI:
    browse/upload/delete SD files). network.txt/wifi.txt gitignored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
2026-07-21 Supervisor web UI: create folders (mkdir)
    POST /api/mkdir?path=/p/name -> f_mkdir, plus a "+ New folder" button in the
    page (prompts for a name, creates it in the current folder). So you can make
    a cart/disk folder and upload into it, all from the browser.
    Verified from a LAN host: mkdir /webtest -> upload into it -> delete file +
    folder, clean.
2026-07-21 Supervisor web UI: breadcrumb path navigation
    Render the current path as clickable segments (root '/' + each level), so
    e.g. on /atari/800/cartridge/BASIC clicking 'cartridge' jumps straight there.
    Replaces the plain-text path label.
    [httpsrv.c]
2026-07-21 Supervisor WiFi: don't deinit cyw43 on toggle-off (fixes console hang)
    Toggling WiFi off called cyw43_arch_deinit(), which in poll mode wedged the
    cooperative loop and left the CDC console dead (while lwIP still pinged).
    wifi_off() now just disconnects (cyw43_arch_disable_sta_mode) and keeps cyw43
    initialised; wifi_poll() stays a cheap no-op, wifi_on() re-joins.
    Verified: on -> off -> on cycle with the console responsive throughout.
    (WiFi already defaults off at boot; this makes the off toggle safe.)
    [wifi.c]
2026-07-21 Supervisor: sort cart/disk pickers A-Z; web UI folder filter
    config_list_subdirs() now qsorts the folder names case-insensitively, so the
    supervisor menu's [c] cart and [1-4] disk pickers are alphabetical instead of
    raw f_readdir (creation) order. (The default cart still comes from config.json.)
    Web UI: add a per-folder filter box (client-side, instant, no refetch) --
    load() now stores entries and render() applies the filter + existing A-Z sort.
    Handy as the cart/disk collections grow. Cleared on navigation.
    Verified: menu lists BASIC/Defender/Galaxian/Gyruss/Pole Position/Star Raiders
    in order; page serves the filter intact.
2026-07-21 Supervisor menu: type-to-filter cart/disk picker
    The [c]/[1-4] pickers are now incremental-search: type letters to filter the
    list (case-insensitive substring), digit to pick (0 = none, 1-9 = filtered
    item), Enter picks the top match, Backspace edits, ESC clears the filter then
    cancels. Works on both the console and the on-screen (USB keyboard) menu --
    hid_to_ascii now passes Space/Backspace/Enter through. Replaces the old
    0-9/a-f tag select (which couldn't scale past a screenful).
    Verified on the console: choose cart -> type 'st' -> list narrows to
    Star Raiders -> 1 selects it.
    [supervisor.c]
2026-07-21 Supervisor menu: show "connecting..." while WiFi joins
    wifi_on() blocks several seconds (cyw43 init + join), so on the on-screen
    menu a 'w' press looked ignored until it finished. The 'w' handler now sets a
    g_wifi_connecting flag and repaints the menu (which flushes to the HDMI
    overlay) BEFORE the blocking call, so it immediately shows
    "[w] wifi: connecting..." then resolves to ON + IP (or off on failure).
    Verified: menu shows connecting... then "ON 192.168.0.228".
    [supervisor.c]
2026-07-21 Docs: supervisor UX (sort/filter/F8), network SD manager, STAMP-USB note
    - STATUS.md: new "Supervisor UX + network SD manager" section — A-Z +
    type-to-filter cart/disk pickers, F8 -> SYSTEM RESET, and the Pico 2 W
    WiFi + HTTP web UI (browse/upload/mkdir/delete over the network). Cross-board
    note: shared firmware + F8 verified on the 10CL025+STAMP; that STAMP's native
    USB physically broke -> flash via SWD, SD via card reader.
    - Wukong README: WiFi/web-UI section + API, 'N' console cmd, key files.
    - 10CL025 ARCHITECTURE: current-state pointer to STATUS.md + the SWD-flash /
    card-reader / Quartus-rebuild workflow now that the STAMP USB is dead.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
2026-07-21 Remove the JOP soft-core: drop jop-spinalhdl submodule + Java + JOP tops
    The Atari supervisor is the RP2040/Pico C firmware now; JOP is no longer used.
    - Delete the jop-spinalhdl submodule (.gitmodules updated) and the JOP-only
    Scala: Atari800JopTop / Atari800Ep4cgx150{Jop,DualPll}Top / JopCoreForAtari*
    / AtariCtrl / VgaTextOverlayDevice / AtariBoardConfig / GenerateConstJava /
    Atari800JopSim{,Tb}, plus the Atari800JopTopSv generator.
    - Delete java/apps/AtariSupervisor (the JOP Java app) and jop-atari.json.
    - SioBridge (still used by the Wukong/LG tops) depended only on jop.io.HasBusIo;
    copy that small trait in as atari800.HasBusIo so it no longer needs JOP.
    - build.sbt: SpinalHDL (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
2026-07-21 README: de-JOP + refresh (intro, Acknowledgements, structure)
    - Intro reframed: SpinalHDL Atari 800 core + RP2040/Pico supervisor; the two
    active boards (10CL025+STAMP 720p, Wukong 1080p); JOP noted as removed.
    - Acknowledgements rewritten to what the repo actually uses: gyurco/Atari800XL,
    SpinalHDL, Digilent rgb2dvi, Pico SDK, TinyUSB, Pico-PIO-USB, FatFs, lwIP +
    CYW43, dirtyJTAG, openFPGALoader; JOP moved to a "Historical" note.
    - Project structure: drop deleted JOP scala / java / jop-spinalhdl / jop-atari.json;
    list the active tops, the supervisor firmware, and the active board dirs; mark
    the EP4CGX150 JOP builds historical.
    - Fix the generate-SV command (Wukong/LG tops); remove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
2026-07-21 Remove historical boards/tops: EP4CGX150/JOP, AC608, CH376, unused_scala
    All preserved in git history; none used by the two active boards.
    - Board dirs: boards/{db_fpga_v4, atari800-lg-v1, atari800-lg-v1.1, AC608, common}
    (EP4CGX150 JOP-era + AC608 + the now-orphaned per-family PLL primitives).
    - Scala tops: Atari800Ep4cgx150Top, Atari800LgV1Top, Atari800CoreAc608,
    Atari800Ecp5BramTop, Ch376UsbKeyboard, and Generate.scala (AC608-only generators).
    - CH376 (superseded by PIO-USB): ch376-to-pmod/ + tools/ch376*.py.
    - unused_scala/ archive; the legacy AC608 top-level Makefile.
    - Extract the two PLL blackboxes still used by kept tops (AtariPll -> LG top +
    SdramTestTop; PllEcp5 -> Ecp5 diag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
    [3DShell_3DShell_ATARI-800-QMTechCB-LG-V1_1_B.step, 3DShell_3DShell_ATARI-800-QMTechCB-LG-V1_1_T.step, BOM_ATARI-800-QMTechCB-LG-V1_1_ATARI-800-QMTechCB-LG-V1_1_2026-04-28.csv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]
2026-07-21 README: drop dead board sections (EP4CGX150/LG-V1/AC608), finish lg-v1 removal
    Follow-up to the historical-board removal:
    - Trim the EP4CGX150 / LG-V1 / LG-V1.1 / legacy-AC608 build sections and their
    resource tables; replace with a concise "Board builds" section for the two
    active boards. Update the structure listing + Status to match.
    - Stage the last two atari800-lg-v1 tracked files (ch376_test) as deleted.
    (Three board photos left untracked — commit or gitignore as you like.)
2026-07-21 10CL025 board: add setup photos (2026-07-21)
    Reference photos of the 10CL025 + RP2040-STAMP bench.
2026-07-21 README: acknowledge MiST / MiSTer as inspiration and references
    Add an Inspiration/references entry crediting the MiST and MiSTer FPGA
    retro-computing platforms; note MiSTer's SDR-RAM + DDR-framebuffer memory
    split, which the Wukong board was chosen to mirror.
2026-07-21 Remove prebuilt LogicAnalyzer binary (unrelated bench tool)
    firmware/prebuilt/LogicAnalyzer.{elf,uf2} was the gusmanb RP2040 logic-analyzer
    firmware flashed to a spare Pico as a bench instrument during bring-up — not
    part of this project's code and not referenced by it (the "logic analyzer"
    mentions in comments just note the instrument). Drop the un-attributed binary
    so the repo has no stray third-party blobs.
2026-07-21 README: credit gusmanb LogicAnalyzer as a bench tool used in bring-up
    Add a Development tools entry acknowledging the RP2040 LogicAnalyzer firmware,
    run on a spare Pico to capture the FPGA debug taps during framebuffer/SPI-link
    bring-up. Noted as tool usage, not a code/design reference.
2026-07-21 README: fix stale Building/Simulation/Resource sections post-cleanup
    - Prerequisites: add the supervisor firmware toolchain (Pico SDK + CMake +
    pyserial); group the FPGA tools by board.
    - Replace the ECP5/Vivado "synthesis" subsections (which invoked the deleted
    Atari800Ecp5BramTop / Atari800JopTop / AC608 fit-checks) with current pointers:
    the ECP5 720p build (oddrx2f_720/, Atari800Ecp5Hdmi720Top), the Colorlight base
    board, and the i9+ hdmi_test probe. Note the old top-level fit-check
    Makefiles/tcl no longer build.
    - Simulation: internal_ram=0 (all RAM via the SDRAM model), not 16384.
    - Resource Utilisation: drop the stale tables (ECP5 BRAM-only + JOP-era XC7A50T
    numbers); stat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
2026-07-21 Remove dead JOP/BRAM fit-check board files
    The i5-7v0/Makefile, the whole i9-7v2/ directory, and i9plus-6v1/
    synth_check.tcl (+ pll_xilinx.sv) were fit-checks against the deleted
    Ecp5BramTop/JOP tops and no longer build. The live ECP5 720p build is
    i5-7v0/oddrx2f_720/ and the live i9+ 1080p timing probe is
    i9plus-6v1/hdmi_test/, both retained.
    Update README project structure/build notes to match and drop the two
    stale synth_util.rpt references from the i9+ board README. Also add the
    Wukong 1080p board photo referenced by the README.
    [pll_ecp5.sv]
2026-07-21 Remove 12 unreachable Scala sources (~1,560 lines)
    Reachability audit from the active roots (board *Sv generate mains, sim
    testbenches, test specs) found these unreferenced by any live top or test:
    superseded: Mmu (folded into AddressDecoder), Ps2Keyboard + Ps2ToAtari800
    (replaced by RpAtariKeyboard SPI link), VgaOverlayMux +
    VgaFullScreenMux (replaced by TextOverlay720/1080),
    SdramArbiter + BmbToSdramReq (replaced by SdramArbiter3)
    unwired: PicoBus, I2cSlave, HdmiLineBuf, AudioPwm, Bundles
    Kept everything live, including Cpu (the wrapper Atari800Core instantiates
    around Cpu65xx) and CompleteAddressDecoder (used by all six chip modules)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
2026-07-21 STATUS: record the JOP-retirement repo cleanup
    Add a "Repo cleanup" section summarising what was removed (JOP soft-core +
    submodule + Java, historical boards/tops, dead fit-checks, 12 unreachable
    Scala sources, dead firmware header + FatFs docs) and surface the key
    cleanup commits in the trail.
2026-07-21 Scrub JOP references from docs, code comments, and gitignore
    JOP is fully retired; remove it as a distraction from the current tree:
    - README: drop the JOP intro note and de-JOP the fit-check parenthetical
    - STATUS: reframe the cleanup section around "legacy soft-core supervisor"
    - code comments: SioBridge/HasBusIo/Atari800Rp2040HdmiLgTop no longer name JOP
    - firmware: sio.h/fpga_link.h drop JOP-origin/JOP-path notes
    - board docs: ARCHITECTURE roadmap, pin-mapping (dead jop-spinalhdl link),
    Wukong README (per-core UARTs)
    - .gitignore: remove dead AC608 JopTop and java/*.jop rules
    Left tools/atari_*.py untouched: they are JOP/UART-era (speak the old 'M'
    peek protocol that now means SDRAM-B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
    [fpga_link.h, sio.h]
2026-07-21 Remove dead JOP/UART-era host tools
    atari_keyboard.py, atari_peek.py, atari_peek_raw.py talked over UART to the
    retired Java supervisor using the old 'K'/'M' protocol. On the RP2040
    supervisor 'M' now means SDRAM-BIST (not RAM peek) and the keyboard is
    USB-host, so these tools no longer work. Superseded by the console 'V'/'y'
    peek and the USB-host keyboard. Drop them from the README structure list.
    This also clears the last JOP references from the tree.
2026-07-21 Add firmware build guide and the two missing board READMEs
    Firmware had no README. Add:
    - firmware/supervisor/README.md — build & flash guide: prerequisites (Pico SDK,
    arm toolchain, Pico-PIO-USB submodule), the -DBOARD=qmtech|colorlight|wukong x
    -DPICO_BOARD matrix, SWD/BOOTSEL flashing, deploy tool, WiFi, and file layout.
    - firmware/README.md — short orientation pointing at supervisor/ and rm2_test/.
    Every board dir now has a README; add the two that were missing:
    - atari-800-rp2040-qmtech-10cl025 (the original 720p board): hardware, the
    BRAM/SDRAM split, Quartus build + sof->rbf->SD flow, firmware target, SD
    layout, known quirks (broken STAMP USB, swapped SWD header).
    - atari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
2026-07-21 Rename board dirs (drop atari-800- prefix) and merge the two Wukong dirs
    The repo is already atari800-spinalhdl, so the per-board atari-800- prefix
    was redundant (i5-7v0/i9plus-6v1 never had it). Rename:
    atari-800-rp2040-colorlight -> rp2040-colorlight
    atari-800-rp2040-qmtech-10cl025 -> rp2040-qmtech-10cl025
    atari-800-rp2040-qmtech-xc7a100t -> rp2040-qmtech-xc7a100t
    atari-800-wukong-1080 -> wukong-1080
    Two sibling dirs for one physical board (atari-800-wukong-1080 = the design,
    qm_xc7a100t_wukong = board notes) read as redundant. Merge the board-hardware
    reference into the design dir:
    qm_xc7a100t_wukong/README.md -> wukong-1080/HARDWARE.md
    qm_xc7a100t_wukon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
    [pinmap.csv]
2026-07-21 Acknowledge wuxx/Colorlight-FPGA-Projects
    Credit the community Colorlight i5/i9/i9+ reference (pinouts, schematics,
    open-source flow) in the root README Acknowledgements and in each Colorlight
    board README (i5-7v0, i9plus-6v1, rp2040-colorlight).
2026-07-22 XC7A100T board: adopt v2 netlist (link fix) + Wukong-equivalence verdict
    Consolidate to a single canonical baseboard netlist. The v2 export fixes
    the missing FPGA<->RP2040 SPI link (SPI0_CLK/COPI/CIPO = FPGA K26/K25/J21
    <-> RP2040 GPIO18/19/20, plus 6 spare GPIO taps); older v1/2026-07-19
    exports removed.
    Record the verified Wukong-equivalence in ARCHITECTURE.md: same die and
    speed grade (xc7a100tfgg676-2), same 50 MHz reference clock (U22 vs the
    Wukong's M21), and the same memory complement (on-module MT41K128M16 DDR3
    via MIG + a W9825G6KH SDR added on the baseboard). Open items noted: HDMI
    100 nF AC-coupling caps on TMDS_33, DDR3/clock XDC + RTL retarget still to
    do, and the U22 reference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
2026-07-24 Restructure SpinalHDL into retro.* packages; add Archimedes port docs
    Split the flat `atari800` package (98 files in one namespace) into a
    machine-neutral root `retro` with layered packages, ahead of adding a
    second machine (Archimedes):
    retro.common.{util,video,scaler,sdram} reusable IP
    retro.link FPGA side of the RP2040 link
    retro.machines.atari the Atari 800 core
    retro.boards board tops + *Sv generators
    Dependency rule: boards -> machines -> common,link; common never imports a
    machine. The split surfaced three real couplings the flat namespace hid,
    each resolved by moving the file to where its dependenci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
2026-07-24 Rename sbt module atari/ -> hdl/; move SioBridge to machines/atari
    The last Atari-specific label in the structure was the sbt module dir `atari/`.
    Renamed the module directory and id `atari` -> `hdl` (kept `retro` as the Scala
    root). Updated every `atari/runMain` / `atari/src` reference in build.sbt, README,
    STATUS, board Makefiles, i5-7v0 build scripts and docs. The runtime SD-card path
    `/atari/800/...` (the Atari machine's data dir) is unrelated and deliberately
    left unchanged.
    Also corrected a mis-scoped file surfaced while reviewing: SioBridge (and its sim)
    implement the Atari **SIO** serial protocol for disk emulation -> they are
    Atari-specific, moved from retro.link to retro.machines.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
2026-07-24 Fix broken SV generation: embed the 8x16 overlay font in Font8x16
    Board bitstream generation had been broken since 8df7c84 ("Remove dead
    firmware header…"), which deleted firmware/supervisor/font8x16.h. That file
    was not dead: Font8x16 read it at elaboration via Source.fromFile to source
    the on-screen overlay glyphs (Font8x16 -> TextOverlay720/1080 -> the Wukong /
    Rp2040 / Ecp5 board tops). `compile` never touches it, so the break was silent
    until a generator (runMain) ran.
    Recovered the 128x16 glyph bytes from git (8df7c84~1) and embedded them
    directly as a Vector[Int], dropping the repo-root-relative Source.fromFile.
    The font is now self-contained in the HDL — the firmware no longer n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
2026-10-10 fpga-db-colorlight-i5: board review + i9+ HDMI on hardware
    Adds the base board's review, netlists (08-11, 08-12, 10-10), BOM, pin map and
    fit-check, plus i9+ HDMI test bitstreams in hdmi_bars/.
    HDMI result: the board AC-couples every TMDS lane (100 nF, no pull-ups), so
    TMDS_33 / OBUFDS gives no signal: it needs a DC path to the sink's 3.3 V
    terminations. Pseudo-differential LVCMOS33 (true + complement per lane, as the
    ECP5's LVCMOS33D) shows the 640x480 test pattern with the bars in the right
    order. Corrects the review note and the i9+ README, which both said TMDS_33
    suits the Artix here.
    Open: the picture blanks intermittently; lower-drive variants under test.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
2026-10-10 fpga-db-colorlight-i5: HDMI drive results; i9+ board gets 0R links
    Pseudo-diff LVCMOS33 through the AC caps: DRIVE 16/8 blank more and more over
    minutes, DRIVE 4 holds a clean 640x480. 720p pseudo-diff (hdmi720_se_top.v, an
    8:1 OSERDESE2 per pin plus a 10->8 gearbox) is noisy, then blanks.
    This board is an i9+ board, so C1-C7/C10 become 0 ohm links and the Artix
    drives TMDS_33 DC-coupled (hdmi_bars_top.v). With links fitted, the pseudo-
    diff builds must never be loaded.
    Claude-Session: https://claude.ai/code/session_01JGk6x2SNtDGHmo5azsEoyK
2026-10-10 hdmi_bars: delete the pseudo-diff builds before the 0R links go in
    With C1-C7/C10 replaced by links, a pseudo-diff LVCMOS33 build would drive
    push-pull 3.3 V straight into the sink's 50 ohm terminations. No board we
    have needs them after the rework, so they go rather than sitting behind a
    rule. Last present in d77c30e; the results stay in the README.
    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
